slburris/Projects-FINTA/KiCAD/gps/errata.txt

Resolved in 1.1

Q2 is hidden on silkscreen after transistor is installed
Raspberry pi header is rotated 180 degrees

Unresolved

Display connector is wrong type, should be from the PH series
Adafruit GPS pinout silkscreen not visible after module is mounted, should also
J10 (USB A connector) should have plated through holes for the two mounting pins
0.22uf COG cap not available in 0603
