slburris/Projects-FINTA/KiCAD/disciplined-ocxo/disciplined-ocxo.pdf

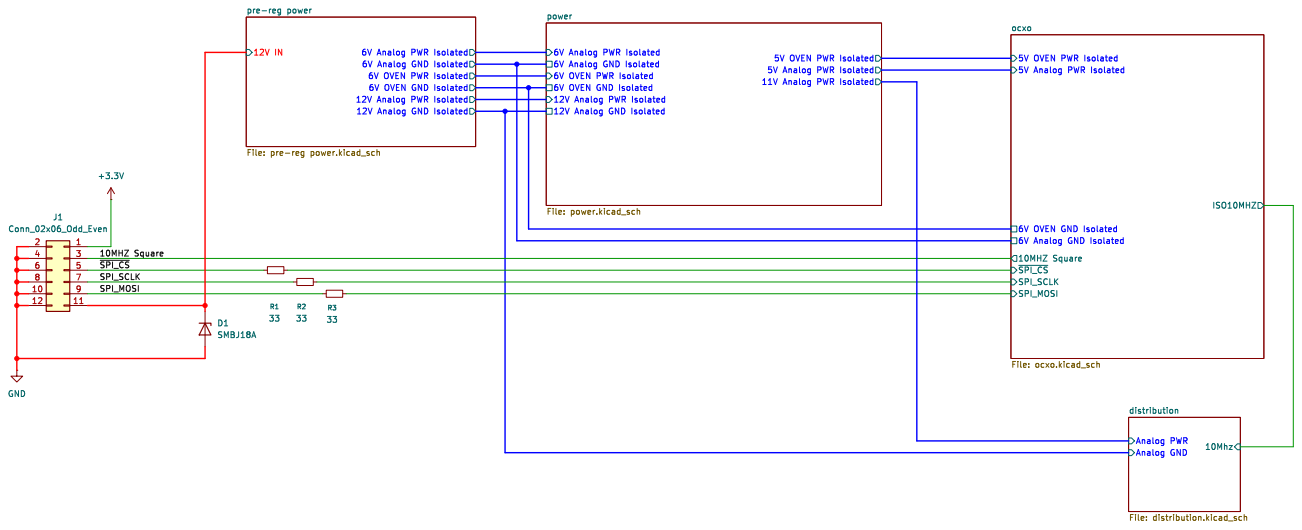
[picture p1: page 1]

6V Analog PWR Isolated
5V OVEN PWR Isolated 6V Analog GND Isolated
6V OVEN GND Isolated
12V Analog PWR Isolated
12V Analog GND Isolated

Id: 1/9 Title: File: disciplined-ocxo.kicad_sch Sheet: /

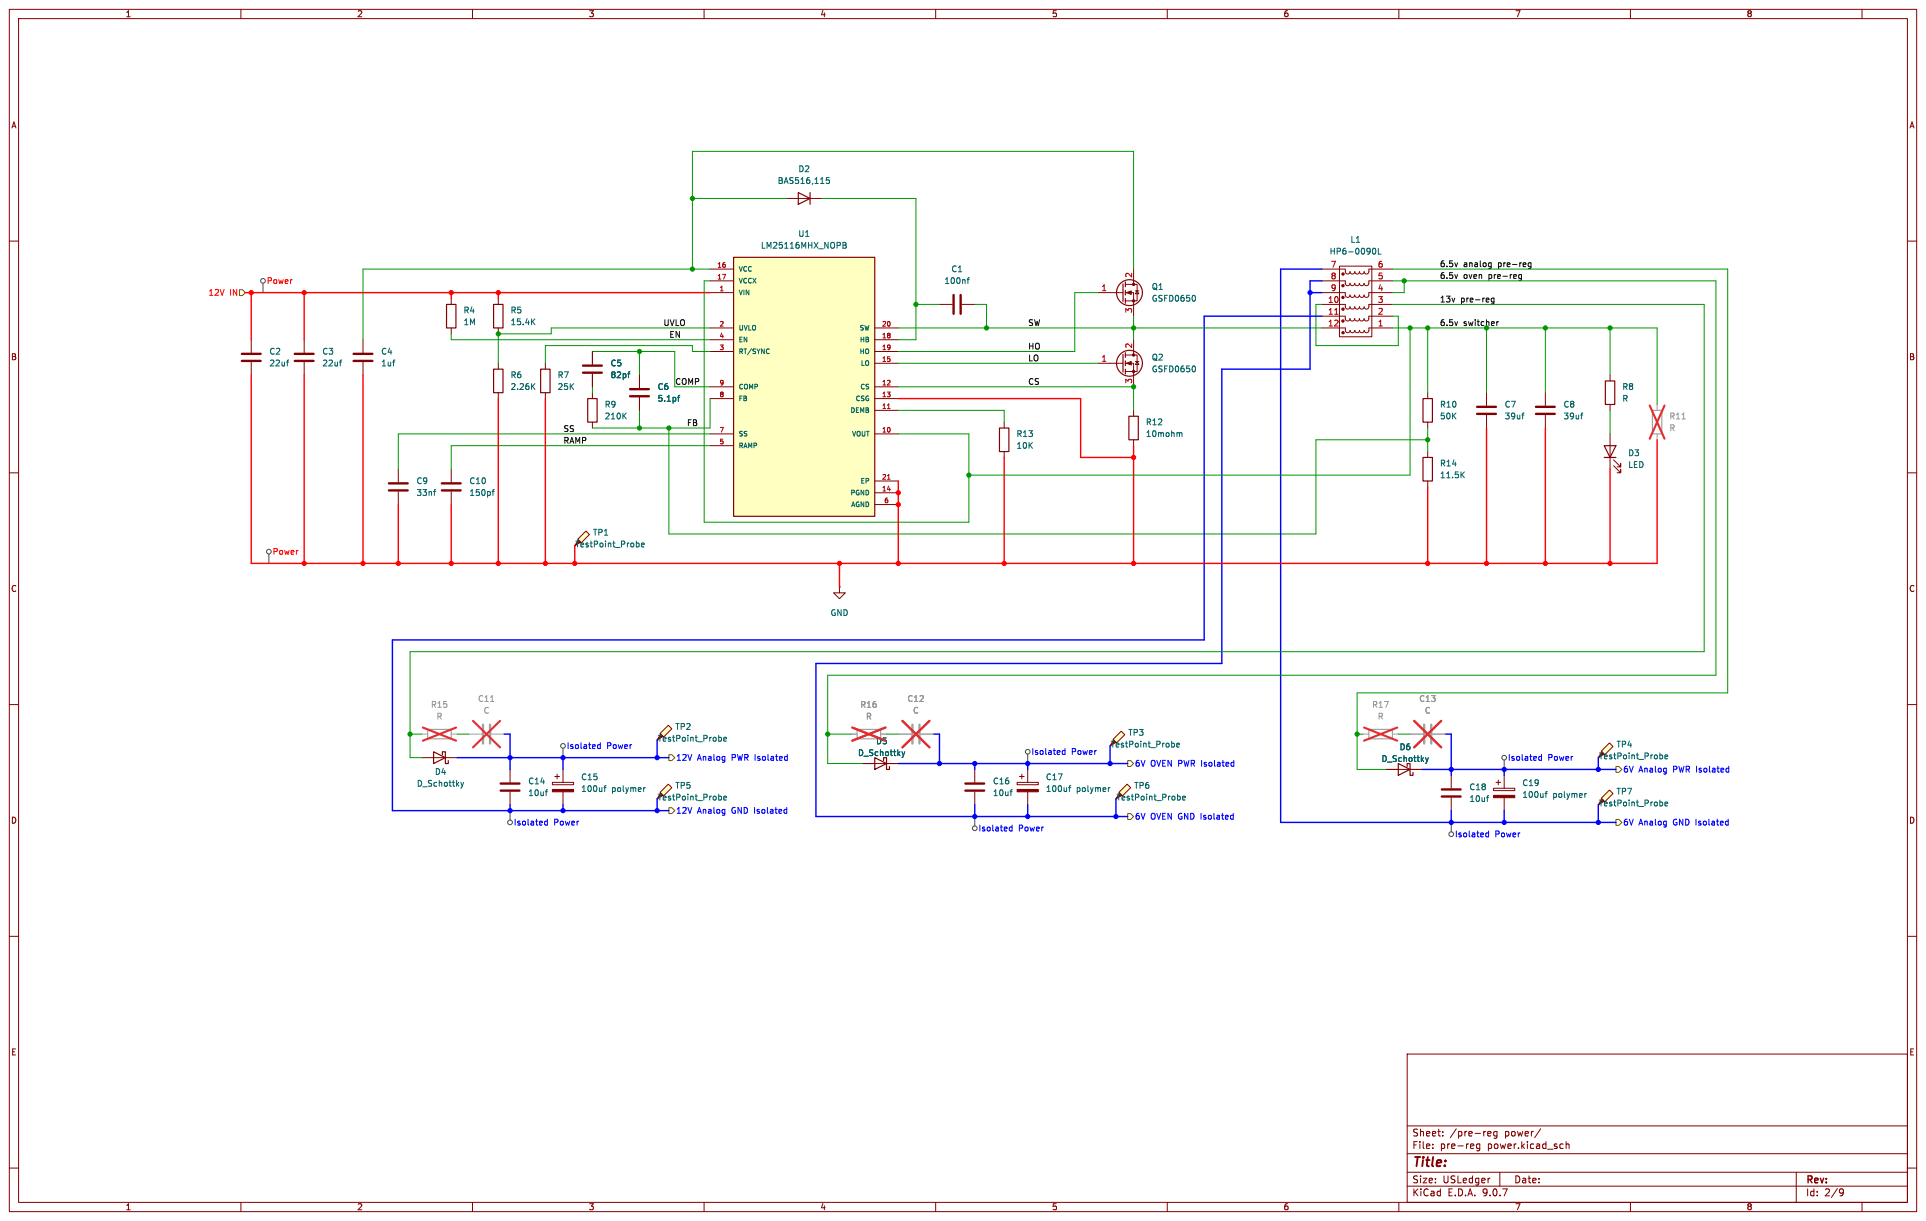
[picture p2: page 2]

6.5v analog pre-reg FB

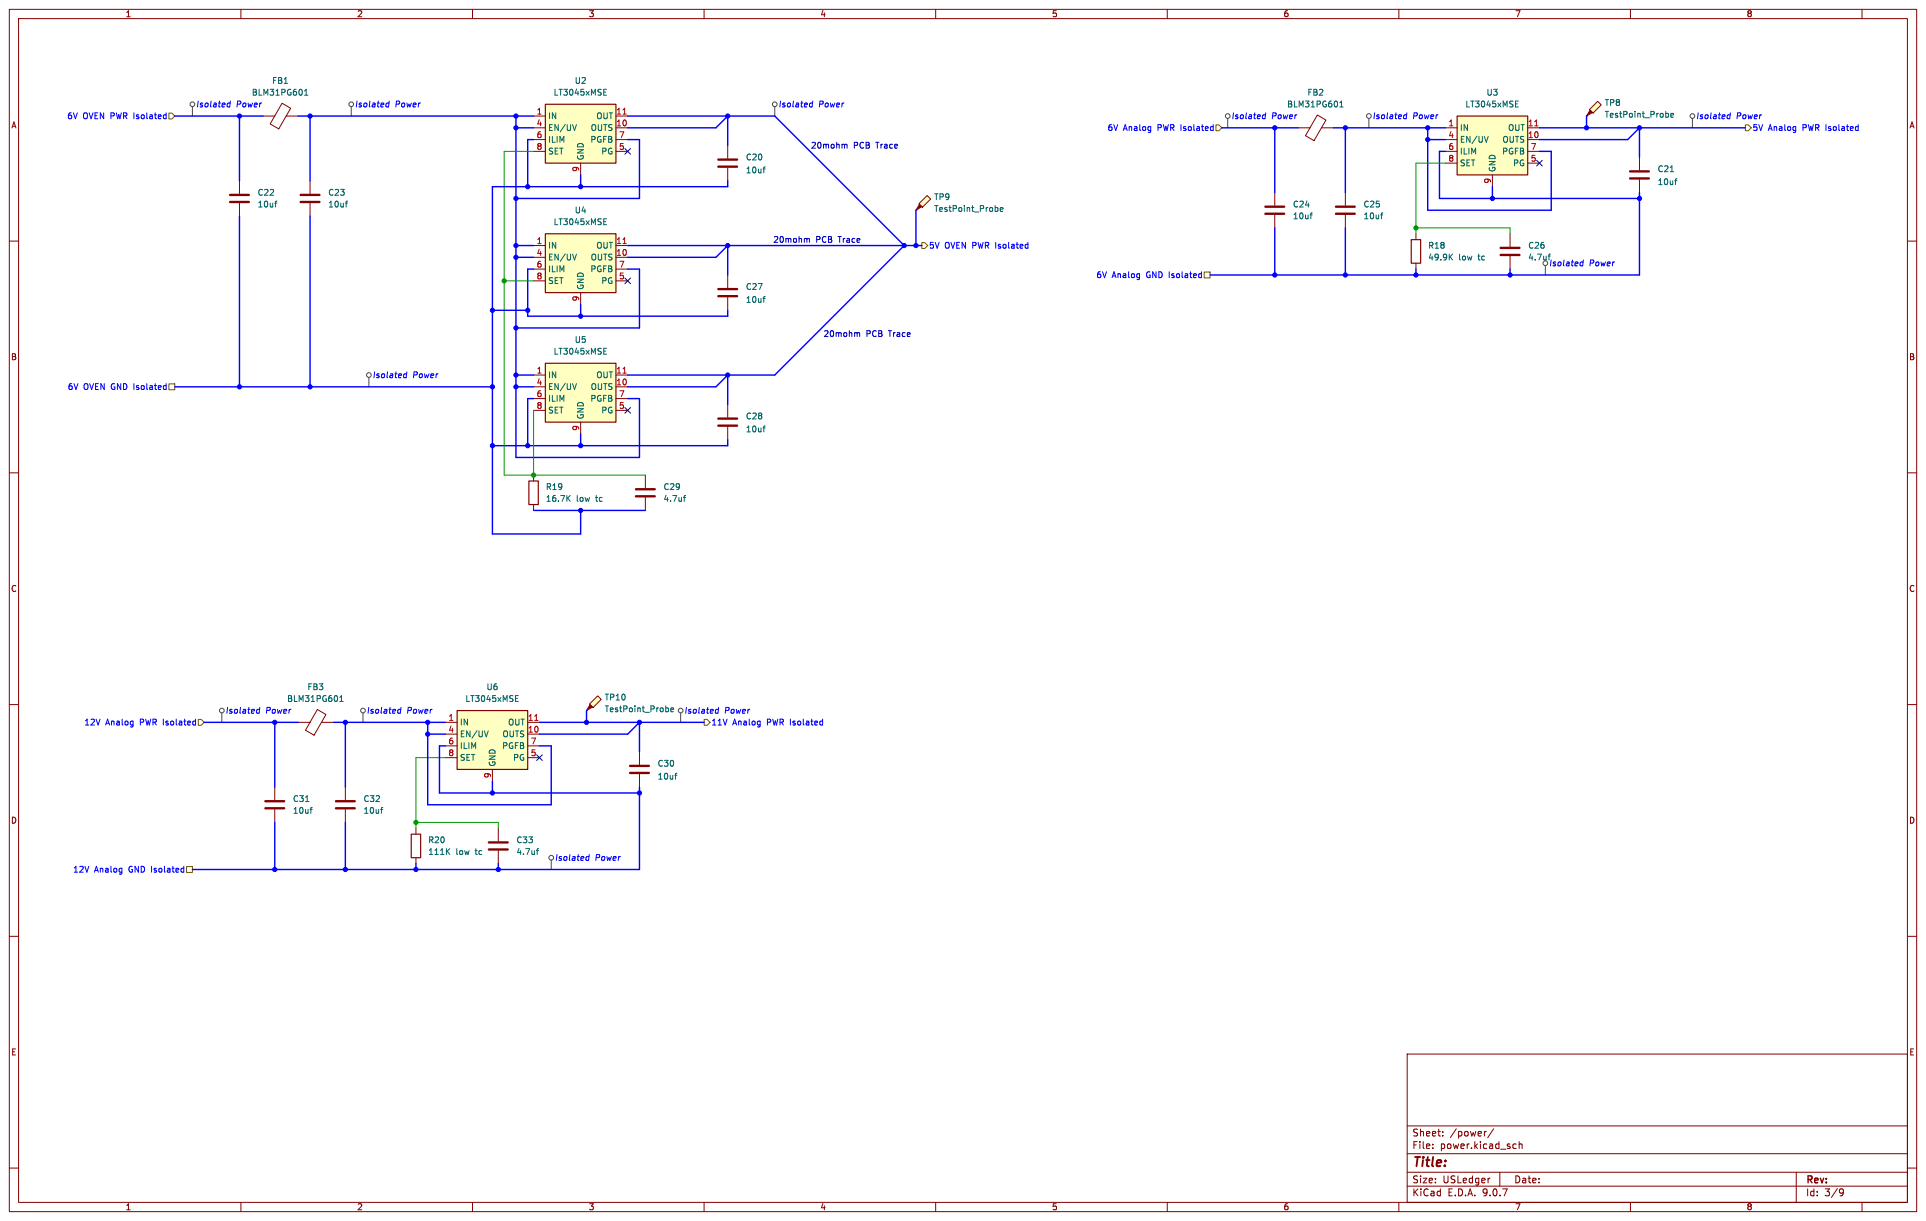
[picture p3: page 3]

9 OUT 11 OUTS 10 PGFB 7 PG 5 U2
LT3045xMSE

9 OUT 11 OUTS 10 PGFB 7 PG 5 U3

9 OUT 11 OUTS 10 PGFB 7 PG 5 U4

9 OUT 11 OUTS 10 PGFB 7 PG 5 U5

9 OUT 11 OUTS 10 PGFB 7 PG 5 U6

Id: 3/9 Title: File: power.kicad_sch Sheet: /power/

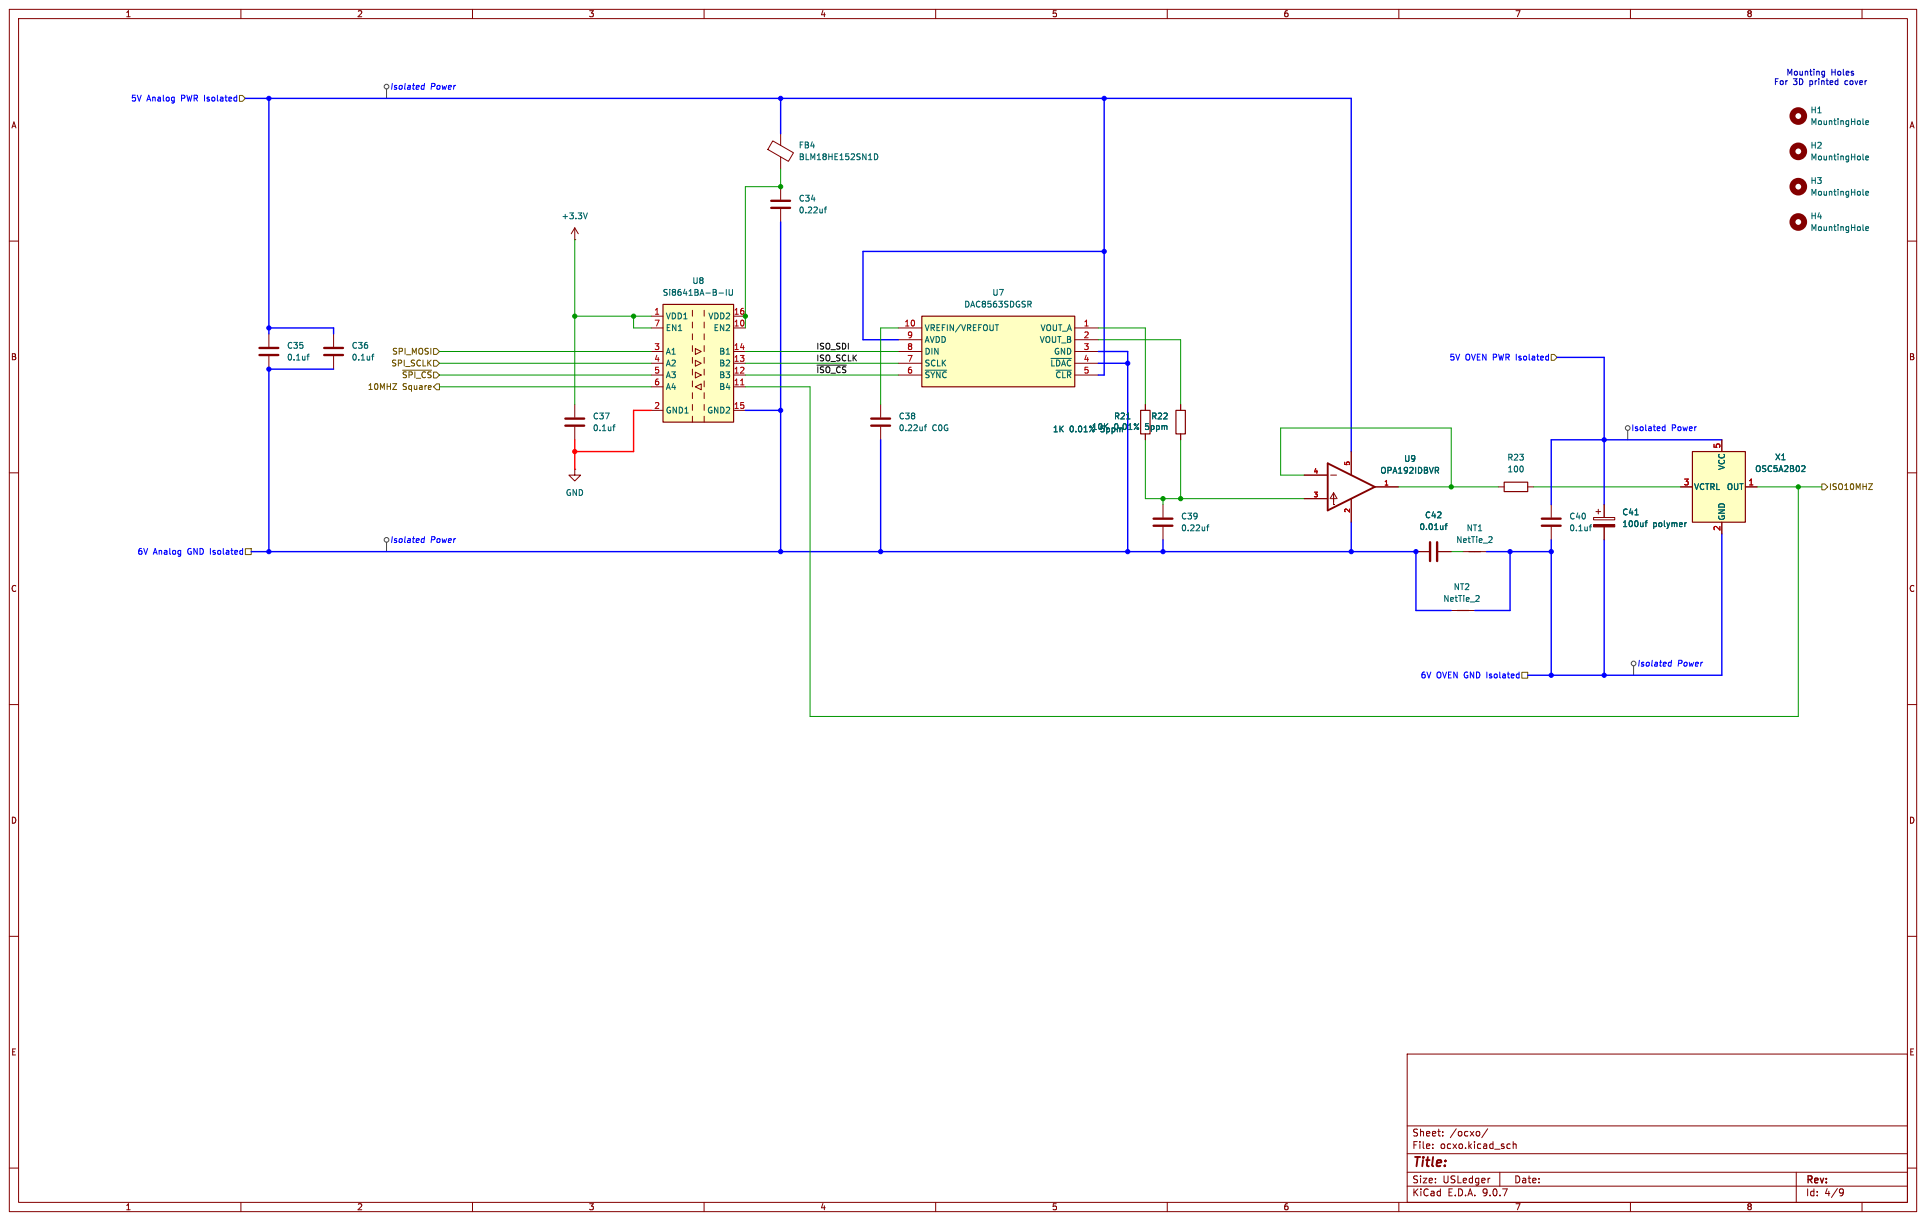
[picture p4: page 4]

Isolated Power 6V Analog GND Isolated

Id: 4/9 Title: File: ocxo.kicad_sch Sheet: /ocxo/

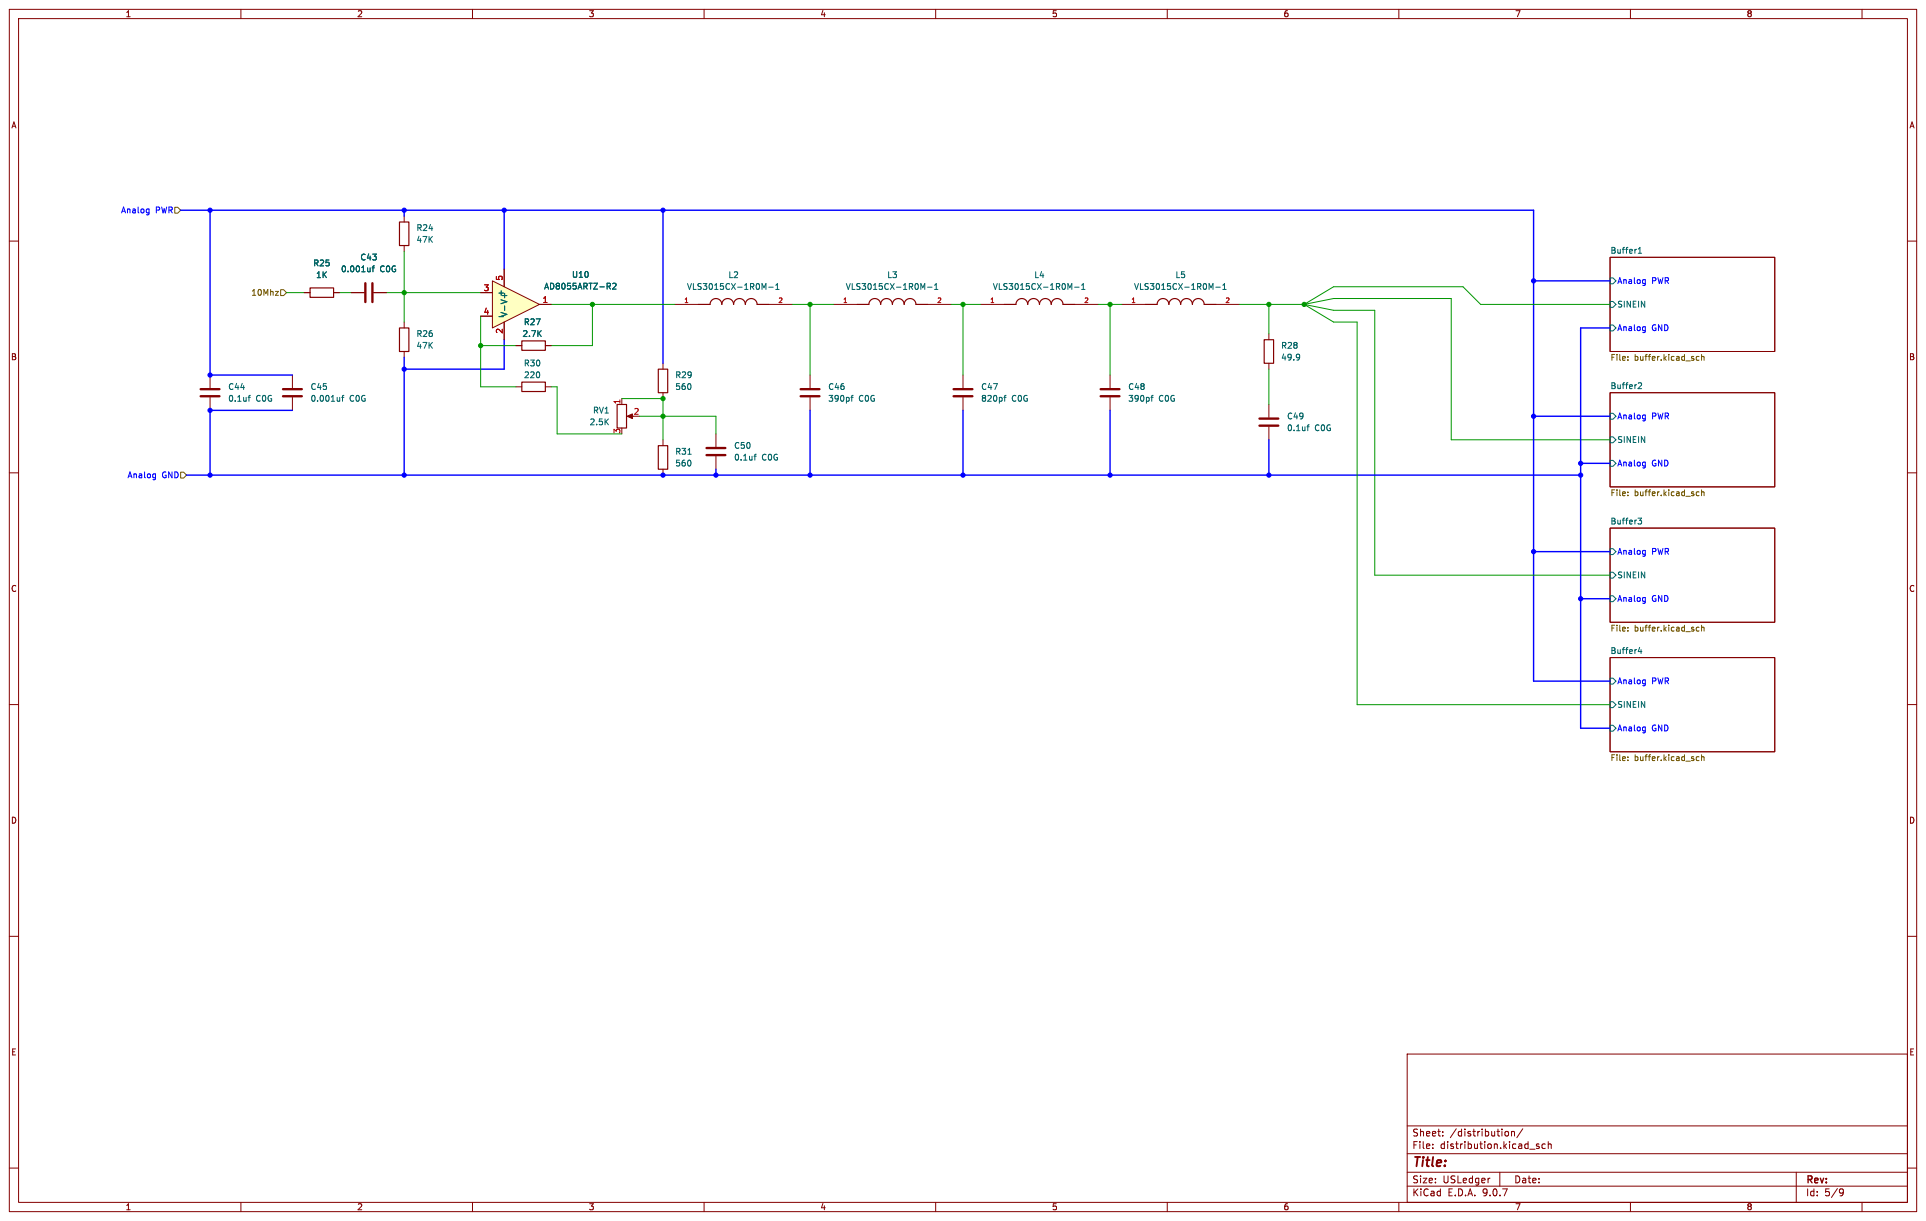
[picture p5: page 5]

Id: 5/9 Title: File: distribution.kicad_sch Sheet: /distribution/

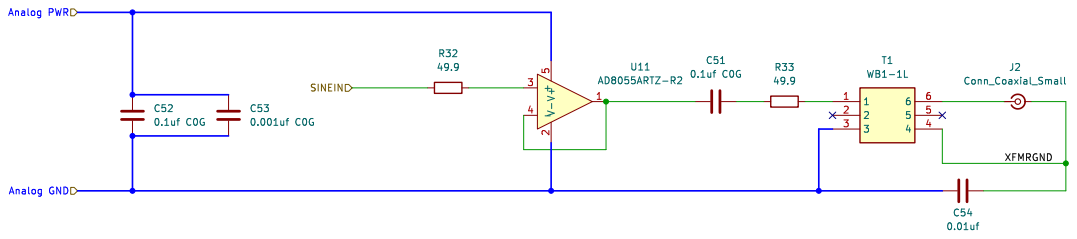
[picture p6: page 6]

Id: 6/9 Title: File: buffer.kicad_sch Sheet: /distribution/Buffer1/

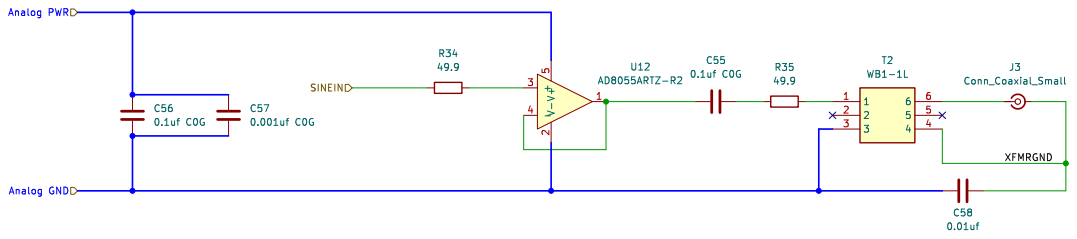
[picture p7: page 7]

Id: 7/9 Title: File: buffer.kicad_sch Sheet: /distribution/Buffer2/

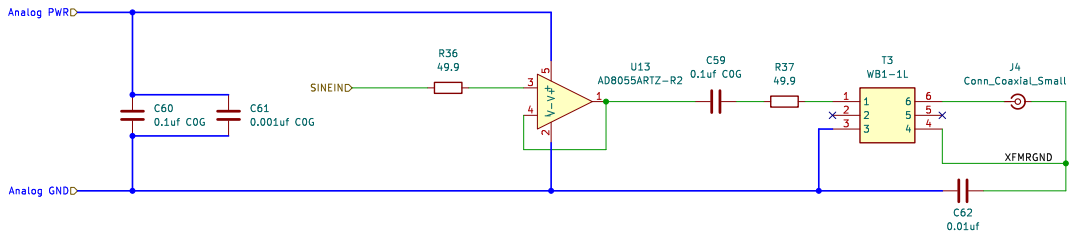
[picture p8: page 8]

Id: 8/9 Title: File: buffer.kicad_sch Sheet: /distribution/Buffer3/

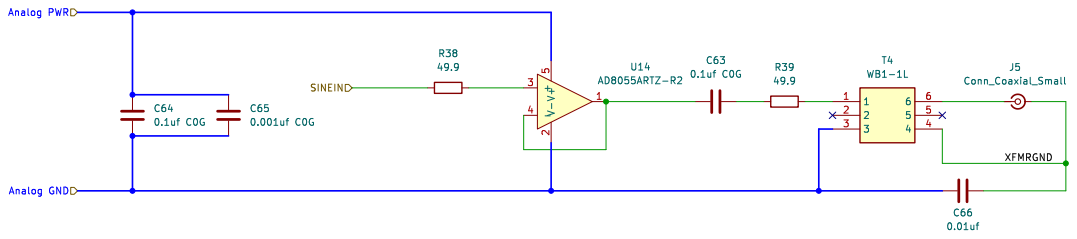
[picture p9: page 9]

Id: 9/9 Title: File: buffer.kicad_sch Sheet: /distribution/Buffer4/
