slburris/Projects-FINTA/KiCAD/IRIG/IRIG.pdf

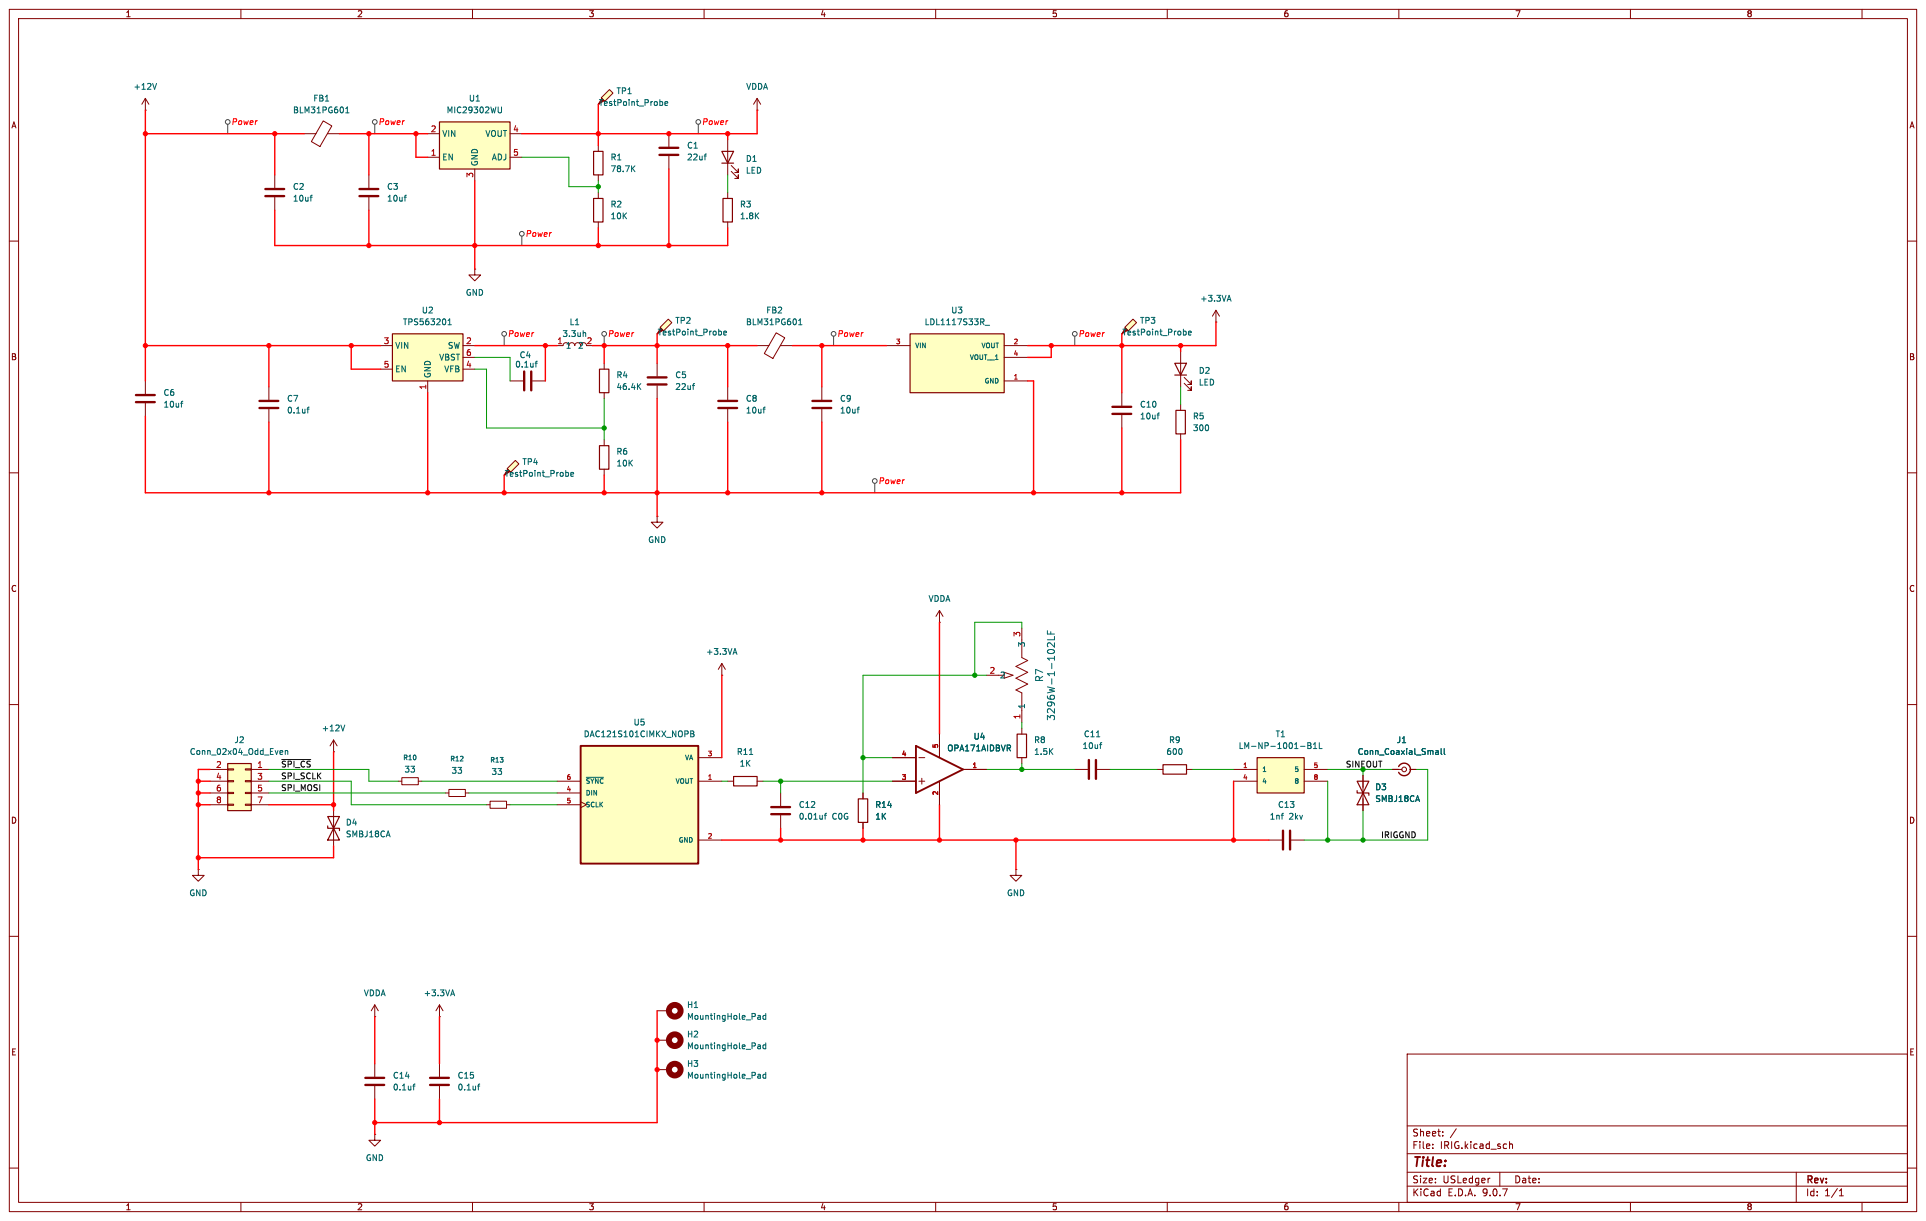
[picture p10: page 1]

Id: 1/1 Title: File: IRIG.kicad_sch Sheet: /
