slburris/Projects-FINTA/KiCAD/lownoise-LDO/lownoise-LDO.kicad_pcb

## KiCad design KiCAD/lownoise-LDO/lownoise-LDO.kicad_pcb (2026-05-15)

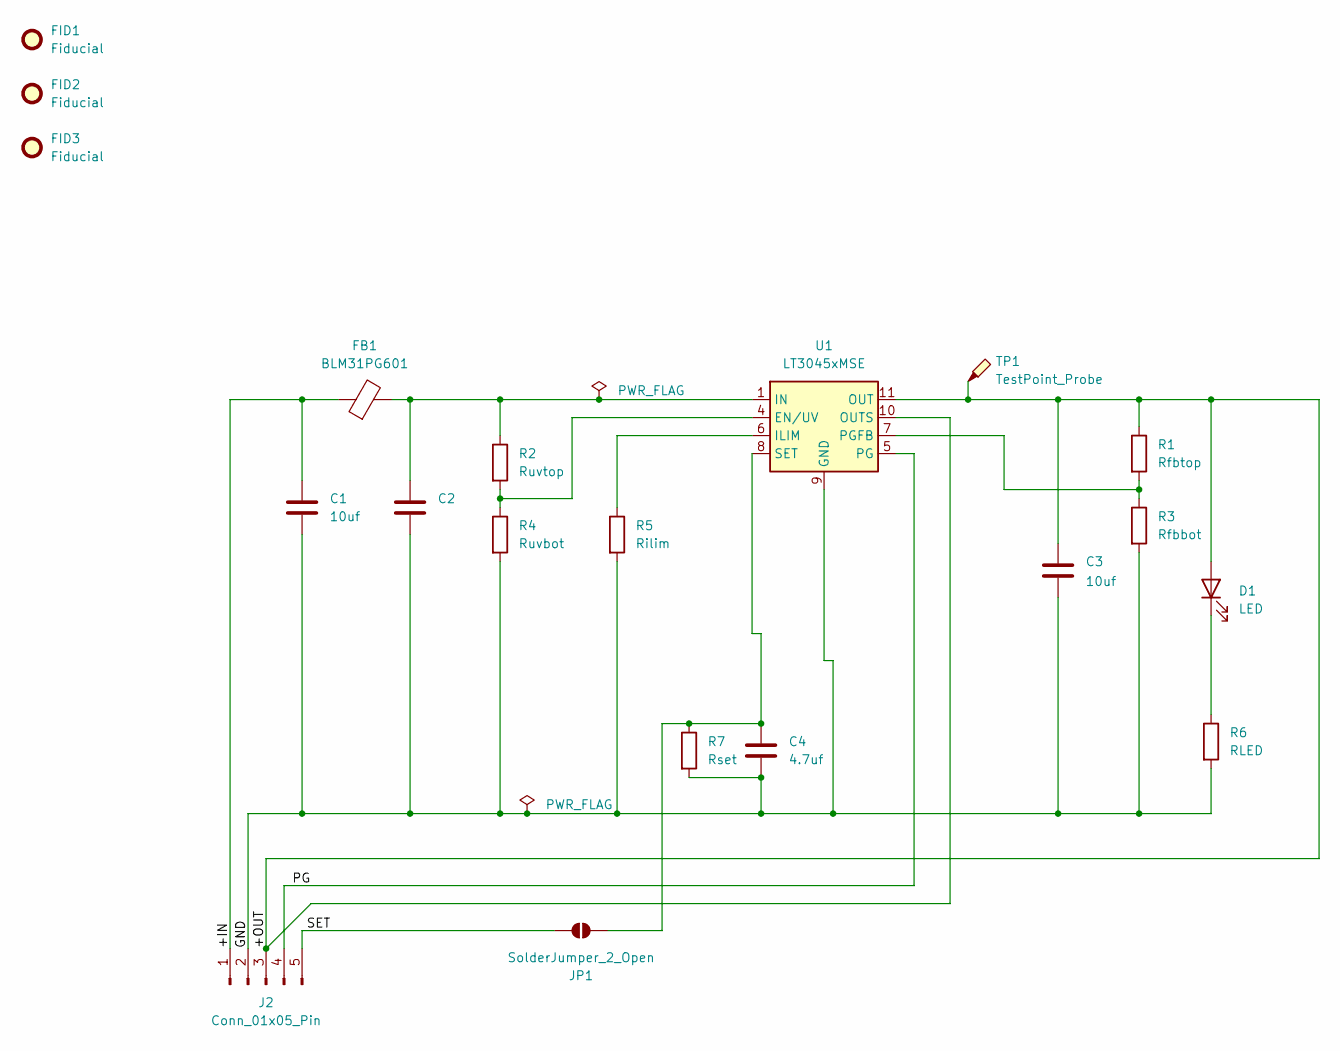
[picture p11: schematic lownoise-LDO.kicad_sch]

Parts:
C1, C2, C3: 10uf; C_0603_1608Metric_Pad1.08x0.95mm_HandSolder
C4: 4.7uf; C_0603_1608Metric_Pad1.08x0.95mm_HandSolder
D1: LED; LED_D3.0mm_Horizontal_O1.27mm_Z2.0mm
FB1: BLM31PG601; L_1206_3216Metric_Pad1.22x1.90mm_HandSolder
FID1, FID2, FID3: Fiducial; Fiducial_1mm_Mask2mm
J2: Conn_01x05_Pin; PinHeader_1x05_P2.00mm_Horizontal
JP1: SolderJumper_2_Open; SolderJumper-2_P1.3mm_Open_TrianglePad1.0x1.5mm
R1: Rfbtop; R_0603_1608Metric_Pad0.98x0.95mm_HandSolder
R2: Ruvtop; R_0603_1608Metric_Pad0.98x0.95mm_HandSolder
R3: Rfbbot; R_0603_1608Metric_Pad0.98x0.95mm_HandSolder
R4: Ruvbot; R_0603_1608Metric_Pad0.98x0.95mm_HandSolder
R5: Rilim; R_0603_1608Metric_Pad0.98x0.95mm_HandSolder
R6: RLED; R_0603_1608Metric_Pad0.98x0.95mm_HandSolder
R7: Rset; R_0603_1608Metric_Pad0.98x0.95mm_HandSolder
TP1: TestPoint_Probe; TestPoint_Pad_2.0x2.0mm
U1: LT3045xMSE; MSOP-12-1EP_3x4.039mm_P0.65mm_EP1.651x2.845mm

Connections:
/+IN: C1.1, FB1.1, J2.1
/+OUT: C3.1, D1.2 (A), J2.3, R1.1, TP1.1, U1.10 (OUTS), U1.11 (OUT), U1.12 (OUT)
/GND: C1.2, C2.2, C3.2, C4.2, J2.2, R3.2, R4.2, R5.2, R6.2, R7.2, U1.9 (GND), U1.13 (GND)
/PG: J2.4, U1.5 (PG)
/SET: J2.5, JP1.1 (A)
unnamed: C2.1, FB1.2, R2.1, U1.1 (IN), U1.2 (IN), U1.3 (IN)
unnamed: D1.1 (K), R6.1
unnamed: C4.1, JP1.2 (B), R7.1, U1.8 (SET)
unnamed: R2.2, R4.1, U1.4 (EN/UV)
unnamed: R5.1, U1.6 (ILIM)
unnamed: R1.2, R3.1, U1.7 (PGFB)

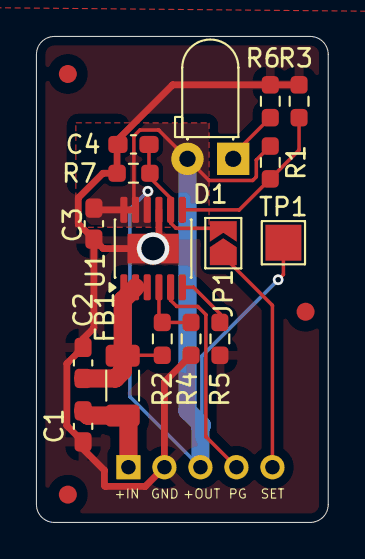
[picture p12: board lownoise-LDO.kicad_pcb from above]

Board: 2 copper layers, 16.2 x 27.0 mm, 20 parts (1 on the bottom side), 11 nets.
