slburris/Projects-FINTA/KiCAD/disciplined-ocxo/disciplined-ocxo.kicad_pcb

## KiCad design KiCAD/disciplined-ocxo/disciplined-ocxo.kicad_pcb (2026-05-14)

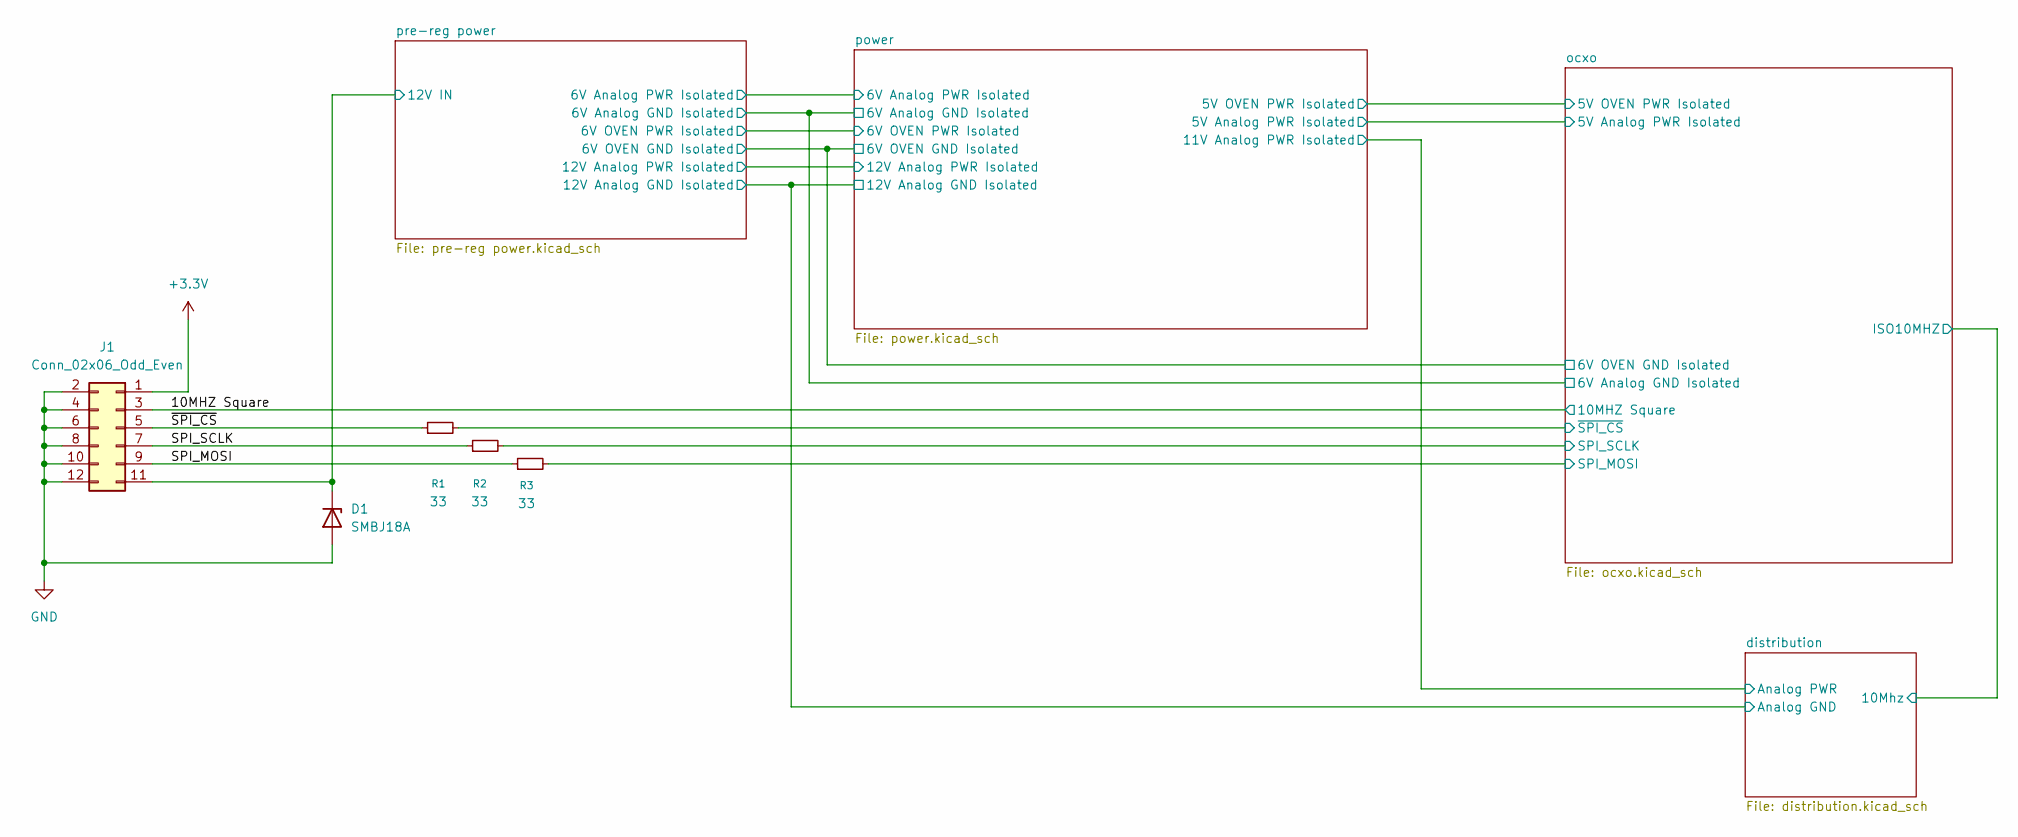
[picture p13: schematic disciplined-ocxo.kicad_sch]

Parts:
D1: SMBJ18A; D_SMB_Handsoldering
J1: Conn_02x06_Odd_Even; PinHeader_2x06_P2.54mm_Horizontal
R1, R2, R3: 33; R_1206_3216Metric_Pad1.30x1.75mm_HandSolder

Connections:
+3.3V: J1.1; also elsewhere on the board
/10MHZ Square: J1.3; also elsewhere on the board
/SPI_MOSI: J1.9, R3.1
/SPI_SCLK: J1.7, R2.1
/ocxo/SPI_MOSI: R3.2; also elsewhere on the board
/ocxo/SPI_SCLK: R2.2; also elsewhere on the board
/ocxo/~SPI_CS: R1.2; also elsewhere on the board
/pre-reg power/12V IN: D1.1 (K), J1.11; also elsewhere on the board
/~SPI_CS: J1.5, R1.1
GND: D1.2 (A), J1.2, J1.4, J1.6, J1.8, J1.10, J1.12; also elsewhere on the board

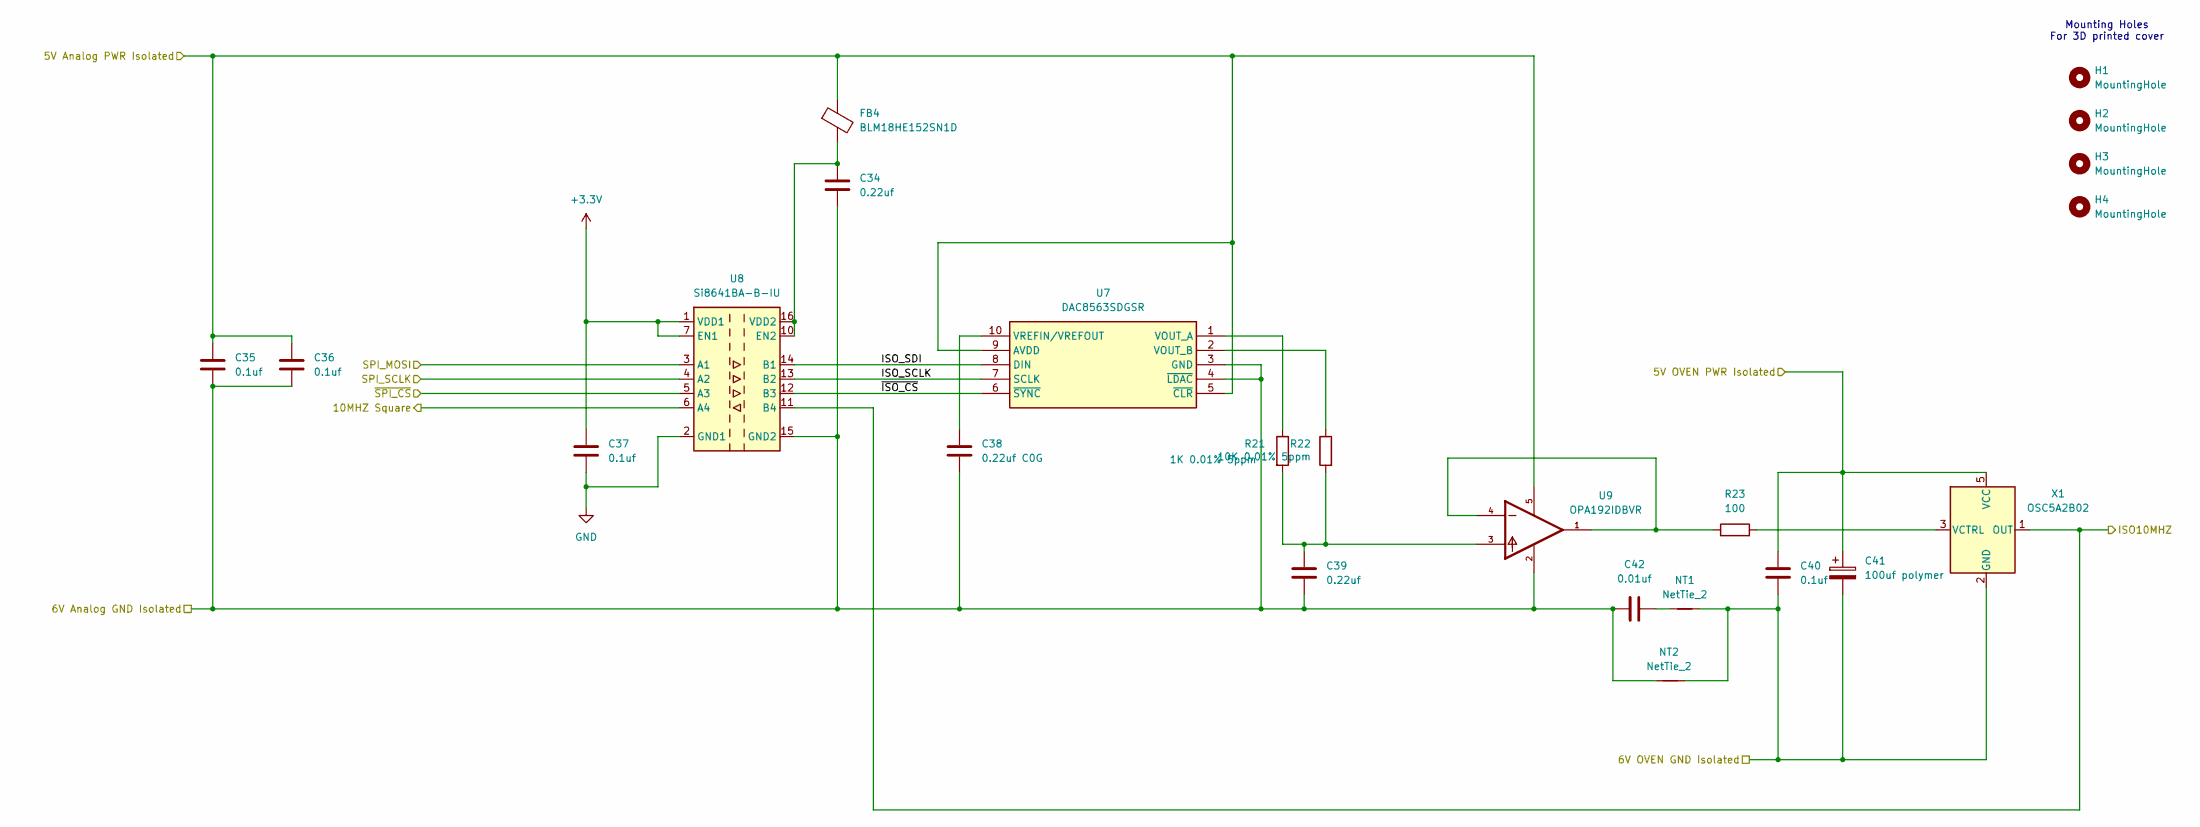
[picture p14: schematic ocxo.kicad_sch]

Parts:
C34, C39: 0.22uf; C_1206_3216Metric_Pad1.33x1.80mm_HandSolder
C35, C36, C37, C40: 0.1uf; C_0603_1608Metric_Pad1.08x0.95mm_HandSolder
C38: 0.22uf C0G; C_0603_1608Metric_Pad1.08x0.95mm_HandSolder
C41: 100uf polymer; CP_Radial_D5.0mm_P2.00mm
C42: 0.01uf; C_0603_1608Metric_Pad1.08x0.95mm_HandSolder
FB4: BLM18HE152SN1D; L_0603_1608Metric_Pad1.05x0.95mm_HandSolder
H1, H2, H3, H4: MountingHole; MountingHole_3.2mm_M3
NT1, NT2: NetTie_2; NetTie-2_SMD_Pad0.5mm
R21: 1K 0.01% 5ppm; R_0805_2012Metric_Pad1.20x1.40mm_HandSolder
R22: 10K 0.01% 5ppm; R_0805_2012Metric_Pad1.20x1.40mm_HandSolder
R23: 100; R_1206_3216Metric_Pad1.30x1.75mm_HandSolder
U7: DAC8563SDGSR; SOP50P490X110-10N; Manufacturer_Part_Number DAC8563SDGSR; Mouser Part Number 595-DAC8563SDGSR
U8: Si8641BA-B-IU; QSOP-16_3.9x4.9mm_P0.635mm
U9: OPA192IDBVR; SOT95P280X145-5N; PARTREV F
X1: OSC5A2B02; CTI-OSC-25x25

Connections:
+3.3V: C37.2, U8.1 (VDD1), U8.7 (EN1); also elsewhere on the board
/10MHZ Square: U8.6 (A4); also elsewhere on the board
/distribution/10Mhz: U8.11 (B4), X1.1 (OUT); also elsewhere on the board
/ocxo/5V Analog PWR Isolated: C35.1, C36.1, FB4.1, U7.5 (~CLR), U7.9 (AVDD), U9.5; also elsewhere on the board
/ocxo/5V OVEN PWR Isolated: C40.1, C41.1, X1.5 (VCC); also elsewhere on the board
/ocxo/6V Analog GND Isolated: C34.2, C35.2, C36.2, C38.2, C39.2, C42.1, NT2.1, U7.3 (GND), U7.4 (~LDAC), U8.9 (GND2), U8.15 (GND2), U9.2; also elsewhere on the board
/ocxo/6V OVEN GND Isolated: C40.2, C41.2, NT1.2, NT2.2, X1.2 (GND); also elsewhere on the board
/ocxo/ISO_SCLK: U7.7 (SCLK), U8.13 (B2)
/ocxo/ISO_SDI: U7.8 (DIN), U8.14 (B1)
/ocxo/SPI_MOSI: U8.3 (A1); also elsewhere on the board
/ocxo/SPI_SCLK: U8.4 (A2); also elsewhere on the board
/ocxo/~ISO_CS: U7.6 (~SYNC), U8.12 (B3)
/ocxo/~SPI_CS: U8.5 (A3); also elsewhere on the board
GND: C37.1, U8.2 (GND1), U8.8 (GND1); also elsewhere on the board
unnamed: C39.1, R21.2, R22.2, U9.3
unnamed: C42.2, NT1.1
unnamed: R23.1, U9.1, U9.4
unnamed: R21.1, U7.1 (VOUT_A)
unnamed: R22.1, U7.2 (VOUT_B)
unnamed: C38.1, U7.10 (VREFIN/VREFOUT)
unnamed: C34.1, FB4.2, U8.10 (EN2), U8.16 (VDD2)
unnamed: R23.2, X1.3 (VCTRL)

Notes on the sheet:
Mounting Holes For 3D printed cover

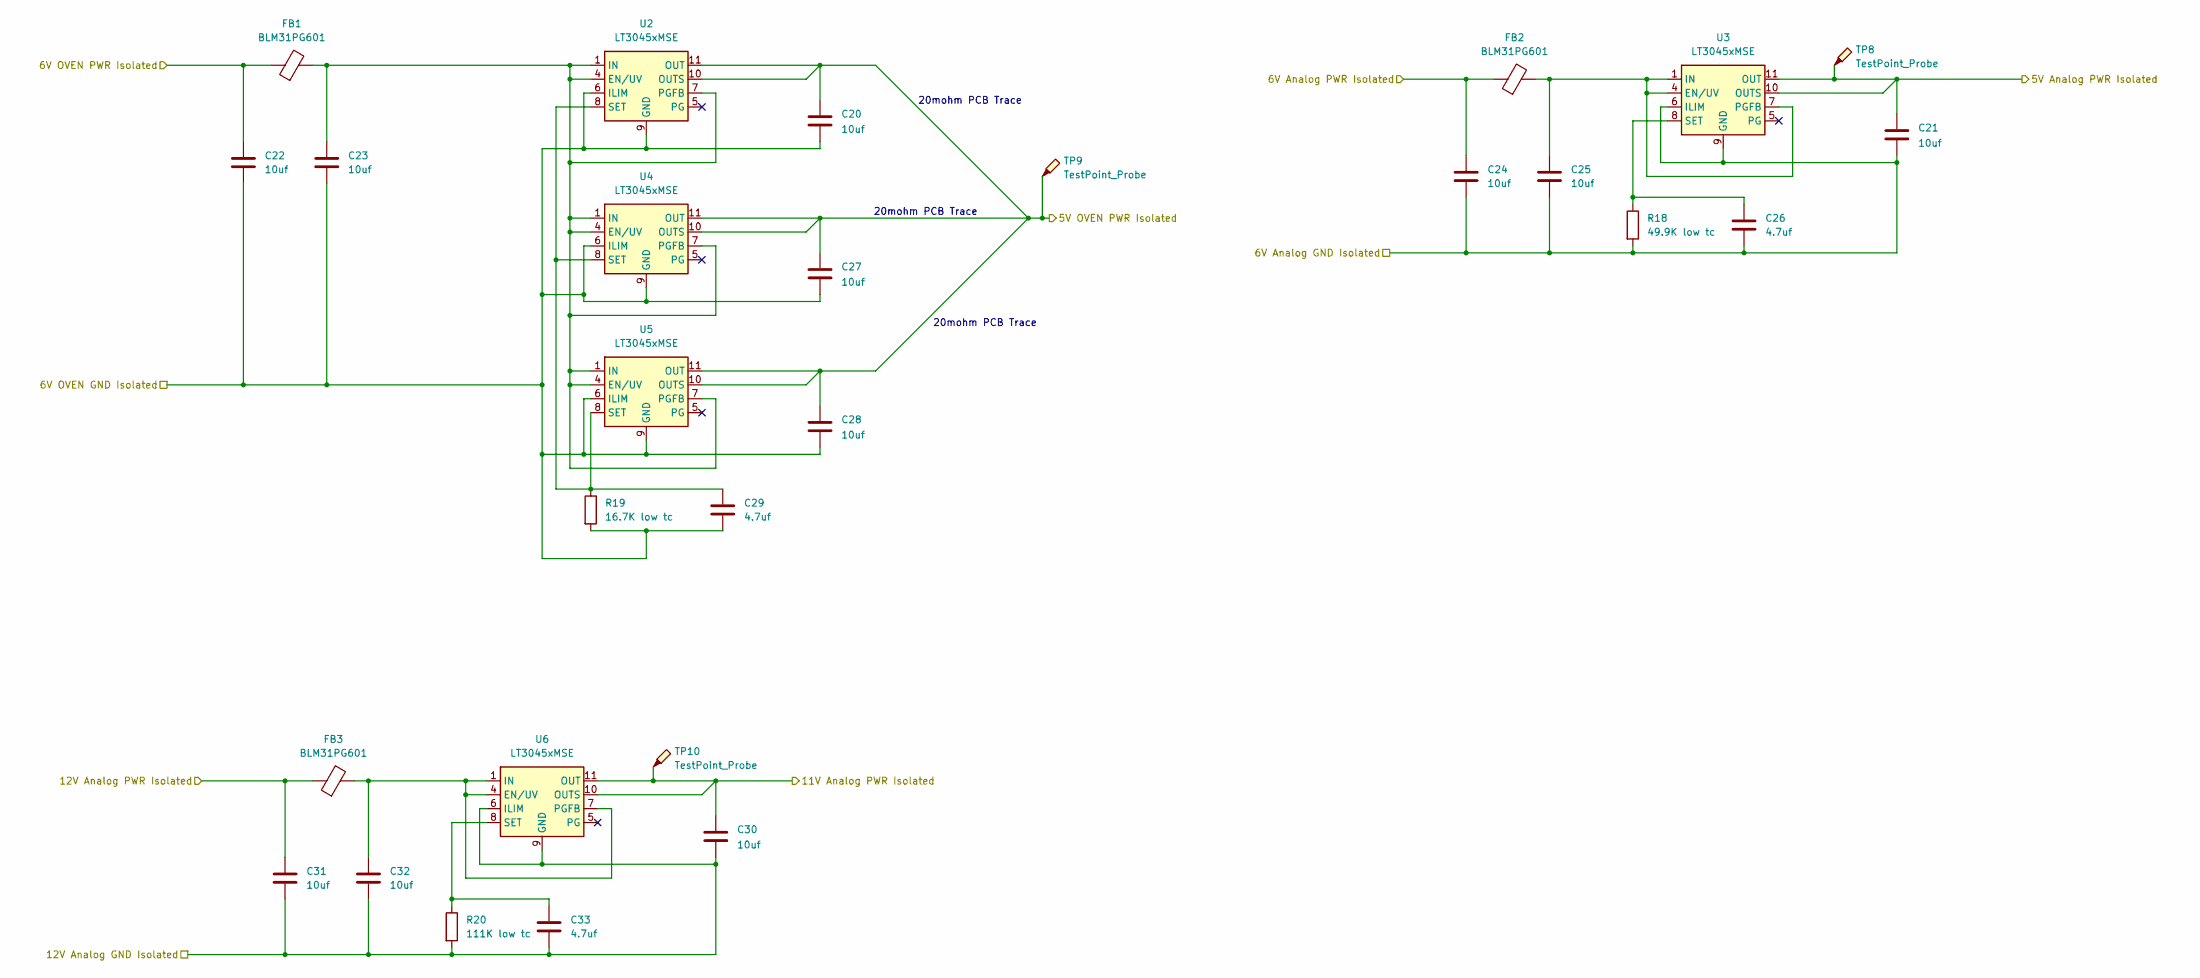
[picture p15: schematic power.kicad_sch]

Parts:
C20, C21, C22, C23, C24, C25, C27, C28, C30, C31, C32: 10uf; C_0603_1608Metric_Pad1.08x0.95mm_HandSolder
C26, C29, C33: 4.7uf; C_0603_1608Metric_Pad1.08x0.95mm_HandSolder
FB1, FB2, FB3: BLM31PG601; L_1206_3216Metric_Pad1.22x1.90mm_HandSolder
R18: 49.9K low tc; R_0603_1608Metric_Pad0.98x0.95mm_HandSolder
R19: 16.7K low tc; R_0603_1608Metric_Pad0.98x0.95mm_HandSolder
R20: 111K low tc; R_0603_1608Metric_Pad0.98x0.95mm_HandSolder
TP8, TP9, TP10: TestPoint_Probe; TestPoint_Pad_2.0x2.0mm
U2, U3, U4, U5, U6: LT3045xMSE; MSOP-12-1EP_3x4.039mm_P0.65mm_EP1.651x2.845mm

Connections:
/distribution/Analog GND: C30.2, C31.2, C32.2, C33.2, R20.2, U6.6 (ILIM), U6.9 (GND), U6.13 (GND); also elsewhere on the board
/distribution/Analog PWR: C30.1, TP10.1, U6.10 (OUTS), U6.11 (OUT), U6.12 (OUT); also elsewhere on the board
/ocxo/5V Analog PWR Isolated: C21.1, TP8.1, U3.10 (OUTS), U3.11 (OUT), U3.12 (OUT); also elsewhere on the board
/ocxo/5V OVEN PWR Isolated: C20.1, C27.1, C28.1, TP9.1, U2.10 (OUTS), U2.11 (OUT), U2.12 (OUT), U4.10 (OUTS), U4.11 (OUT), U4.12 (OUT), U5.10 (OUTS), U5.11 (OUT), U5.12 (OUT); also elsewhere on the board
/ocxo/6V Analog GND Isolated: C21.2, C24.2, C25.2, C26.2, R18.2, U3.6 (ILIM), U3.9 (GND), U3.13 (GND); also elsewhere on the board
/ocxo/6V OVEN GND Isolated: C20.2, C22.2, C23.2, C27.2, C28.2, C29.2, R19.2, U2.6 (ILIM), U2.9 (GND), U2.13 (GND), U4.6 (ILIM), U4.9 (GND), U4.13 (GND), U5.6 (ILIM), U5.9 (GND), U5.13 (GND); also elsewhere on the board
/power/6V Analog PWR Isolated: C24.1, FB2.1; also elsewhere on the board
/power/6V OVEN PWR Isolated: C22.1, FB1.1; also elsewhere on the board
/power/12V Analog PWR Isolated: C31.1, FB3.1; also elsewhere on the board
unnamed: C23.1, FB1.2, U2.1 (IN), U2.2 (IN), U2.3 (IN), U2.4 (EN/UV), U2.7 (PGFB), U4.1 (IN), U4.2 (IN), U4.3 (IN), U4.4 (EN/UV), U4.7 (PGFB), U5.1 (IN), U5.2 (IN), U5.3 (IN), U5.4 (EN/UV), U5.7 (PGFB)
unnamed: C29.1, R19.1, U2.8 (SET), U4.8 (SET), U5.8 (SET)
unnamed: C25.1, FB2.2, U3.1 (IN), U3.2 (IN), U3.3 (IN), U3.4 (EN/UV), U3.7 (PGFB)
unnamed: C26.1, R18.1, U3.8 (SET)
unnamed: C32.1, FB3.2, U6.1 (IN), U6.2 (IN), U6.3 (IN), U6.4 (EN/UV), U6.7 (PGFB)
unnamed: C33.1, R20.1, U6.8 (SET)

Notes on the sheet:
20mohm PCB Trace

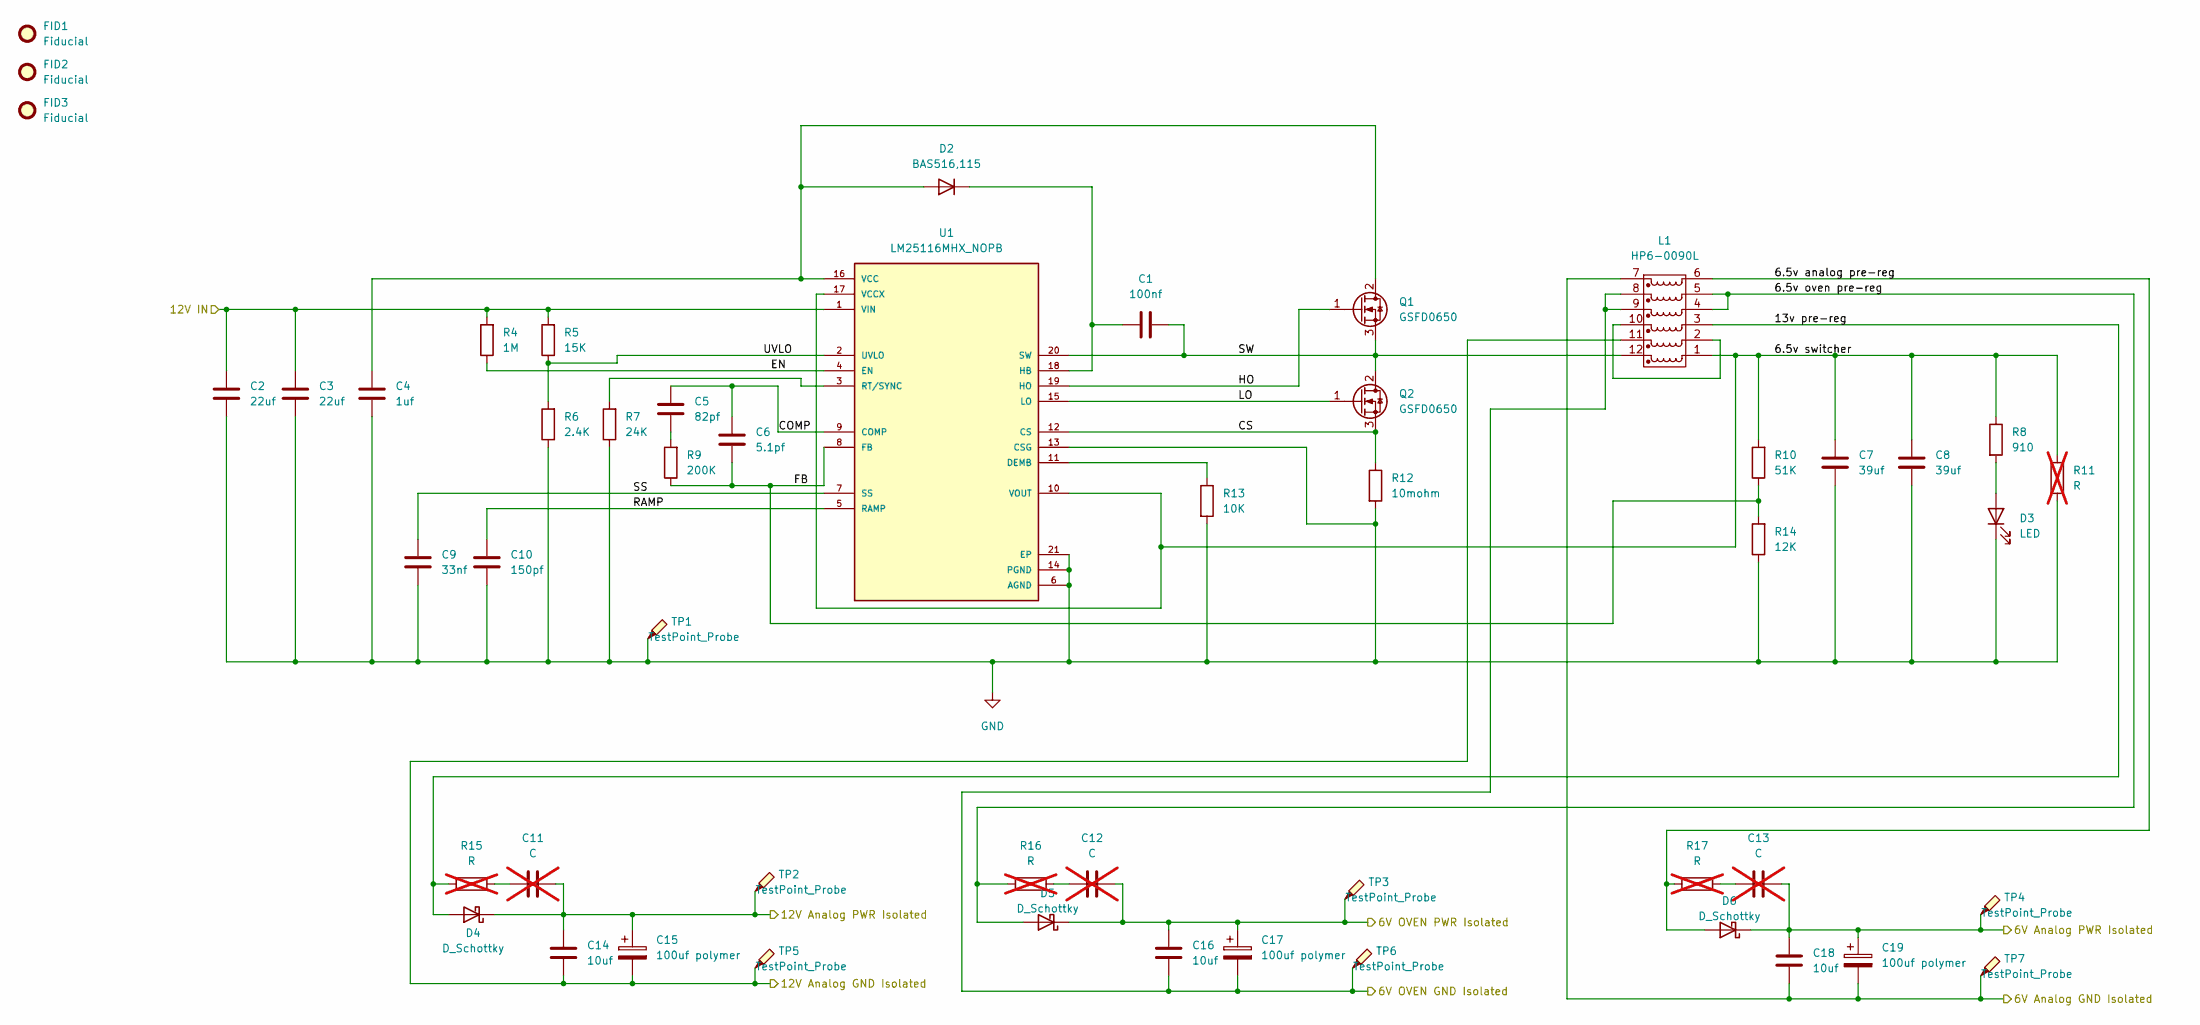
[picture p16: schematic pre-reg power.kicad_sch]

Parts:
C1: 100nf; C_0603_1608Metric_Pad1.08x0.95mm_HandSolder
C2, C3: 22uf; C_1206_3216Metric_Pad1.33x1.80mm_HandSolder
C4: 1uf; C_0603_1608Metric_Pad1.08x0.95mm_HandSolder
C5: 82pf; C_0603_1608Metric_Pad1.08x0.95mm_HandSolder
C6: 5.1pf; C_0603_1608Metric_Pad1.08x0.95mm_HandSolder
C7, C8: 39uf; C_1206_3216Metric_Pad1.33x1.80mm_HandSolder
C9: 33nf; C_0603_1608Metric_Pad1.08x0.95mm_HandSolder
C10: 150pf; C_0603_1608Metric_Pad1.08x0.95mm_HandSolder
C11, C12, C13: C; C_1206_3216Metric_Pad1.33x1.80mm_HandSolder; not fitted
C14, C16, C18: 10uf; C_1206_3216Metric_Pad1.33x1.80mm_HandSolder
C15, C17, C19: 100uf polymer; CP_Radial_D5.0mm_P2.00mm
D2: BAS516,115; D_SOD-523
D3: LED; LED_0805_2012Metric_Pad1.15x1.40mm_HandSolder
D4, D5, D6: D_Schottky; D_SMB_Handsoldering
FID1, FID2, FID3: Fiducial; Fiducial_1mm_Mask3mm
L1: HP6-0090L
Q1, Q2: GSFD0650; TO-252-2
R4: 1M; R_0603_1608Metric_Pad0.98x0.95mm_HandSolder
R5: 15K; R_0603_1608Metric_Pad0.98x0.95mm_HandSolder
R6: 2.4K; R_0603_1608Metric_Pad0.98x0.95mm_HandSolder
R7: 24K; R_0603_1608Metric_Pad0.98x0.95mm_HandSolder
R8: 910; R_1206_3216Metric_Pad1.30x1.75mm_HandSolder
R9: 200K; R_0603_1608Metric_Pad0.98x0.95mm_HandSolder
R10: 51K; R_0603_1608Metric_Pad0.98x0.95mm_HandSolder
R11, R15, R16, R17: R; R_1206_3216Metric_Pad1.30x1.75mm_HandSolder; not fitted
R12: 10mohm; R_1206_3216Metric_Pad1.30x1.75mm_HandSolder
R13: 10K; R_1206_3216Metric_Pad1.30x1.75mm_HandSolder
R14: 12K; R_0603_1608Metric_Pad0.98x0.95mm_HandSolder
TP1, TP2, TP3, TP4, TP5, TP6, TP7: TestPoint_Probe; TestPoint_Pad_2.0x2.0mm
U1: LM25116MHX_NOPB; SOP65P640X110-21N; PARTREV E

Connections:
/distribution/Analog GND: C14.2, C15.2, L1.11, TP5.1; also elsewhere on the board
/ocxo/6V Analog GND Isolated: C18.2, C19.2, L1.7, TP7.1; also elsewhere on the board
/ocxo/6V OVEN GND Isolated: C16.2, C17.2, L1.8, L1.9, TP6.1; also elsewhere on the board
/power/6V Analog PWR Isolated: C13.2, C18.1, C19.1, D6.1 (K), TP4.1; also elsewhere on the board
/power/6V OVEN PWR Isolated: C12.2, C16.1, C17.1, D5.1 (K), TP3.1; also elsewhere on the board
/power/12V Analog PWR Isolated: C11.2, C14.1, C15.1, D4.1 (K), TP2.1; also elsewhere on the board
/pre-reg power/6.5v analog pre-reg: D6.2 (A), L1.6, R17.1
/pre-reg power/6.5v oven pre-reg: D5.2 (A), L1.4, L1.5, R16.1
/pre-reg power/6.5v switcher: C7.1, C8.1, L1.1, R8.1, R10.2, R11.1, U1.10 (VOUT), U1.17 (VCCX)
/pre-reg power/12V IN: C2.1, C3.1, R4.2, R5.2, U1.1 (VIN); also elsewhere on the board
/pre-reg power/13v pre-reg: D4.2 (A), L1.3, R15.1
/pre-reg power/COMP: C5.1, C6.1, U1.9 (COMP)
/pre-reg power/CS: Q2.3 (S), R12.1, U1.12 (CS)
/pre-reg power/EN: R4.1, U1.4 (EN)
/pre-reg power/FB: C6.2, R9.1, R10.1, R14.2, U1.8 (FB)
/pre-reg power/HO: Q1.1 (G), U1.19 (HO)
/pre-reg power/LO: Q2.1 (G), U1.15 (LO)
/pre-reg power/RAMP: C10.1, U1.5 (RAMP)
/pre-reg power/SS: C9.1, U1.7 (SS)
/pre-reg power/SW: C1.2, L1.12, Q1.3 (S), Q2.2 (D), U1.20 (SW)
/pre-reg power/UVLO: R5.1, R6.2, U1.2 (UVLO)
GND: C2.2, C3.2, C4.2, C7.2, C8.2, C9.2, C10.2, D3.1 (K), R6.1, R7.1, R11.2, R12.2, R13.2, R14.1, TP1.1, U1.6 (AGND), U1.13 (CSG), U1.14 (PGND), U1.21 (EP); also elsewhere on the board
unnamed: C5.2, R9.2
unnamed: C11.1, R15.2
unnamed: C12.1, R16.2
unnamed: C13.1, R17.2
unnamed: C4.1, D2.2 (A), Q1.2 (D), U1.16 (VCC)
unnamed: C1.1, D2.1 (K), U1.18 (HB)
unnamed: D3.2 (A), R8.2
unnamed: L1.2, L1.10
unnamed: R13.1, U1.11 (DEMB)
unnamed: R7.2, U1.3 (RT/SYNC)

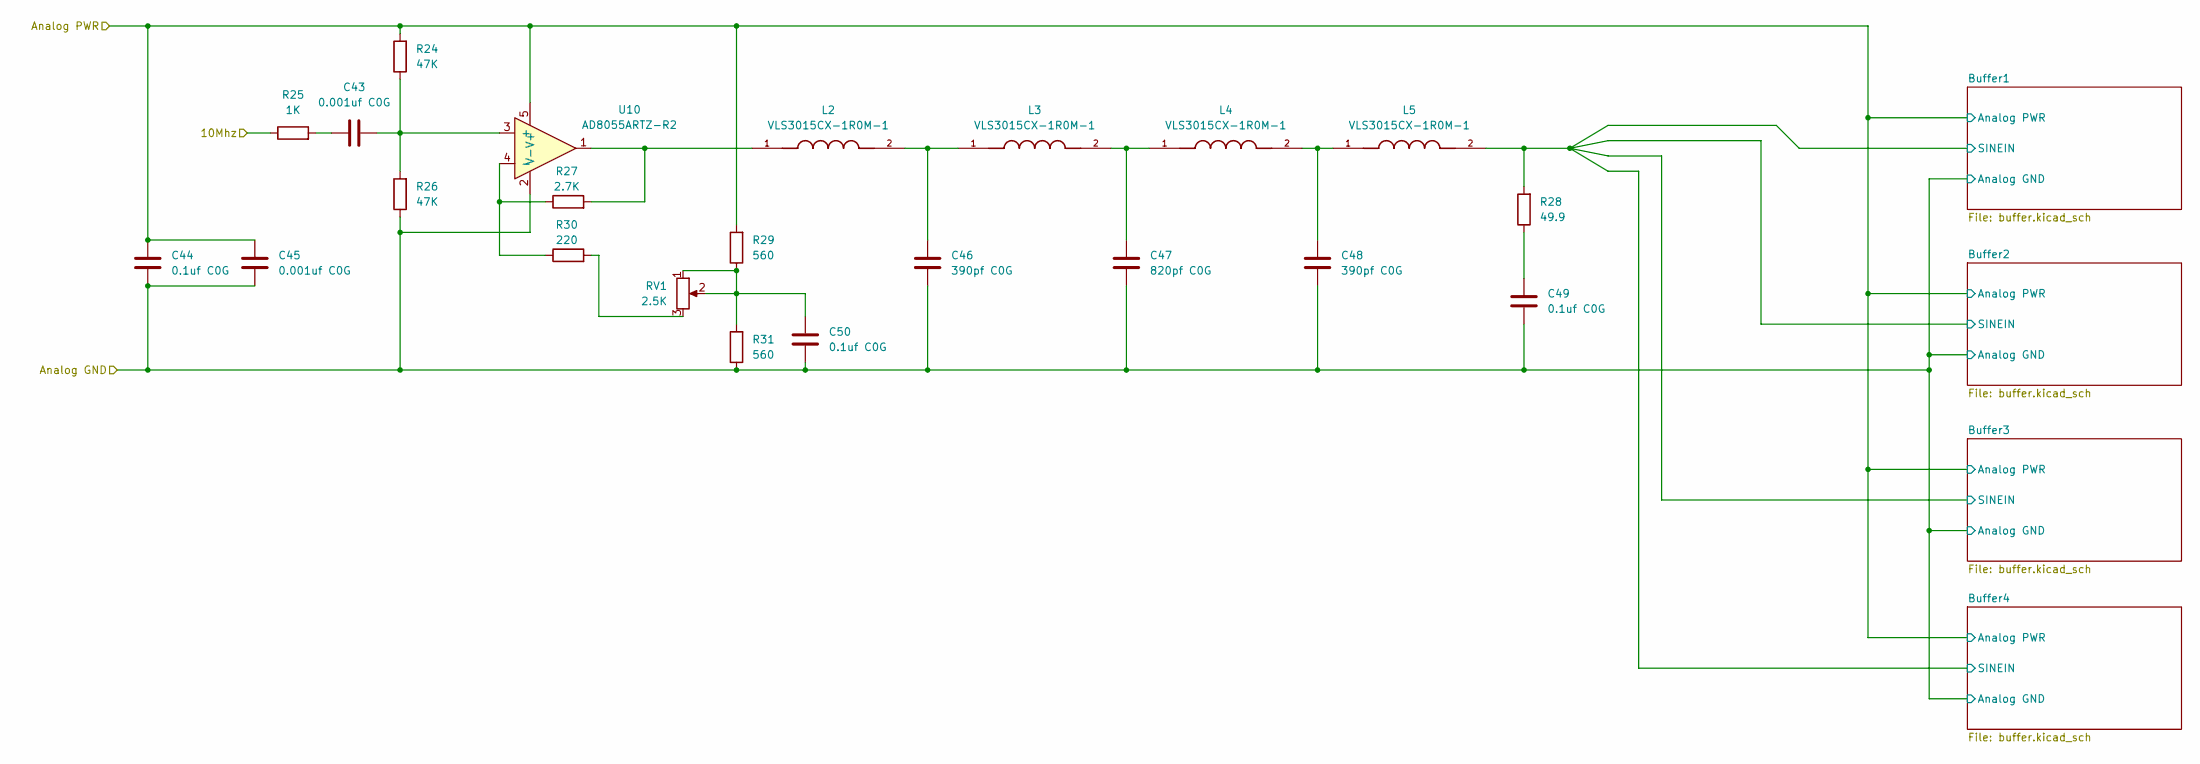
[picture p17: schematic distribution.kicad_sch]

Parts:
C43, C45: 0.001uf C0G; C_1206_3216Metric_Pad1.33x1.80mm_HandSolder
C44, C49, C50: 0.1uf C0G; C_1206_3216Metric_Pad1.33x1.80mm_HandSolder
C46, C48: 390pf C0G; C_1206_3216Metric_Pad1.33x1.80mm_HandSolder
C47: 820pf C0G; C_1206_3216Metric_Pad1.33x1.80mm_HandSolder
L2, L3, L4, L5: VLS3015CX-1R0M-1; IND_VLS3015CX-1R0M-1; PARTREV N/A
R24, R26: 47K; R_1206_3216Metric_Pad1.30x1.75mm_HandSolder
R25: 1K; R_1206_3216Metric_Pad1.30x1.75mm_HandSolder
R27: 2.7K; R_1206_3216Metric_Pad1.30x1.75mm_HandSolder
R28: 49.9; R_1206_3216Metric_Pad1.30x1.75mm_HandSolder
R29, R31: 560; R_1206_3216Metric_Pad1.30x1.75mm_HandSolder
R30: 220; R_1206_3216Metric_Pad1.30x1.75mm_HandSolder
RV1: 2.5K; Potentiometer_Bourns_3296W_Vertical
U10: AD8055ARTZ-R2; SOT95P290X145-5N; MPN AD8055ARTZ-R2

Connections:
/distribution/10Mhz: R25.1; also elsewhere on the board
/distribution/Analog GND: C44.2, C45.2, C46.2, C47.2, C48.2, C49.2, C50.2, R26.1, R31.1, U10.2 (V-); also elsewhere on the board
/distribution/Analog PWR: C44.1, C45.1, R24.2, R29.2, U10.5 (V+); also elsewhere on the board
/distribution/Buffer1/SINEIN: L5.2, R28.2; also elsewhere on the board
unnamed: C43.1, R25.2
unnamed: C46.1, L2.2, L3.1
unnamed: C47.1, L3.2, L4.1
unnamed: C48.1, L4.2, L5.1
unnamed: C49.1, R28.1
unnamed: C50.1, R29.1, R31.2, RV1.1, RV1.2
unnamed: L2.1, R27.2, U10.1
unnamed: R30.2, RV1.3
unnamed: C43.2, R24.1, R26.2, U10.3 (+)
unnamed: R27.1, R30.1, U10.4 (-)

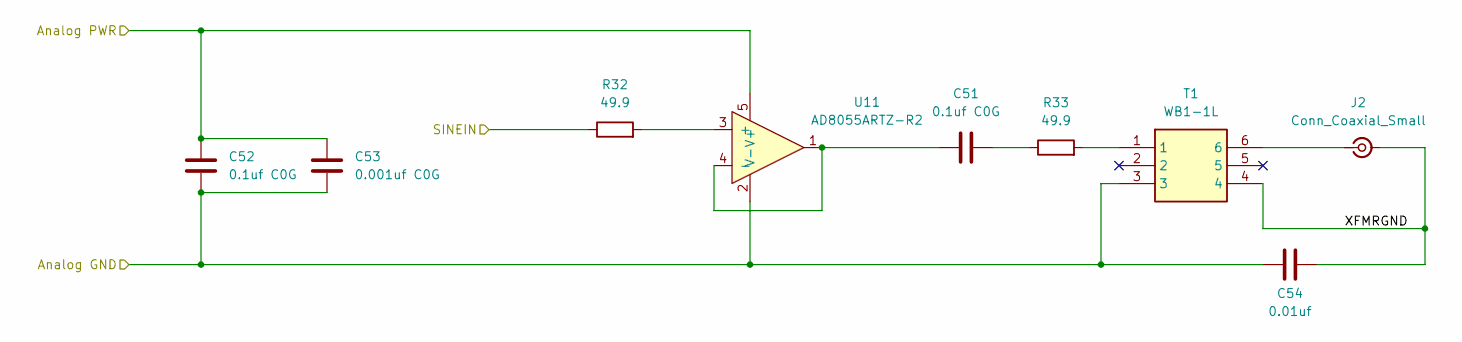
[picture p18: schematic buffer.kicad_sch]

Parts:
C51, C52: 0.1uf C0G; C_1206_3216Metric_Pad1.33x1.80mm_HandSolder
C53: 0.001uf C0G; C_1206_3216Metric_Pad1.33x1.80mm_HandSolder
C54: 0.01uf; C_1206_3216Metric_Pad1.33x1.80mm_HandSolder
J2: Conn_Coaxial_Small; SMA_Amphenol_132291-12_Vertical
R32, R33: 49.9; R_1206_3216Metric_Pad1.30x1.75mm_HandSolder
T1: WB1-1L; DIP762W64P254L826H572Q6N; Manufacturer_Part_Number WB1-1L; Mouser Part Number 994-WB1-1L
U11: AD8055ARTZ-R2; SOT95P290X145-5N; MPN AD8055ARTZ-R2

Connections:
/distribution/Analog GND: C52.2, C53.2, C54.1, T1.3, U11.2 (V-); also elsewhere on the board
/distribution/Analog PWR: C52.1, C53.1, U11.5 (V+); also elsewhere on the board
/distribution/Buffer1/SINEIN: R32.1; also elsewhere on the board
/distribution/Buffer1/XFMRGND: C54.2, J2.2 (Ext), T1.4
unnamed: C51.2, R33.1
unnamed: J2.1 (In), T1.6
unnamed: R33.2, T1.1
unnamed: R32.2, U11.3 (+)
unnamed: C51.1, U11.1, U11.4 (-)

Parts of its further copies:
C55, C56, C59, C60, C63, C64: 0.1uf C0G; C_1206_3216Metric_Pad1.33x1.80mm_HandSolder
C57, C61, C65: 0.001uf C0G; C_1206_3216Metric_Pad1.33x1.80mm_HandSolder
C58, C62, C66: 0.01uf; C_1206_3216Metric_Pad1.33x1.80mm_HandSolder
J3, J4, J5: Conn_Coaxial_Small; SMA_Amphenol_132291-12_Vertical
R34, R35, R36, R37, R38, R39: 49.9; R_1206_3216Metric_Pad1.30x1.75mm_HandSolder
T2, T3, T4: WB1-1L; DIP762W64P254L826H572Q6N; Manufacturer_Part_Number WB1-1L; Mouser Part Number 994-WB1-1L
U12, U13, U14: AD8055ARTZ-R2; SOT95P290X145-5N; MPN AD8055ARTZ-R2

Connections of its further copies:
/distribution/Analog GND: C56.2, C57.2, C58.1, C60.2, C61.2, C62.1, C64.2, C65.2, C66.1, T2.3, T3.3, T4.3, U12.2 (V-), U13.2 (V-), U14.2 (V-); also elsewhere on the board
/distribution/Analog PWR: C56.1, C57.1, C60.1, C61.1, C64.1, C65.1, U12.5 (V+), U13.5 (V+), U14.5 (V+); also elsewhere on the board
/distribution/Buffer1/SINEIN: R34.1, R36.1, R38.1; also elsewhere on the board
/distribution/Buffer2/XFMRGND: C58.2, J3.2 (Ext), T2.4
/distribution/Buffer3/XFMRGND: C62.2, J4.2 (Ext), T3.4
/distribution/Buffer4/XFMRGND: C66.2, J5.2 (Ext), T4.4
unnamed: C55.2, R35.1
unnamed: C59.2, R37.1
unnamed: C63.2, R39.1
unnamed: J3.1 (In), T2.6
unnamed: J4.1 (In), T3.6
unnamed: J5.1 (In), T4.6
unnamed: R35.2, T2.1
unnamed: R37.2, T3.1
unnamed: R39.2, T4.1
unnamed: R34.2, U12.3 (+)
unnamed: C55.1, U12.1, U12.4 (-)
unnamed: R36.2, U13.3 (+)
unnamed: C59.1, U13.1, U13.4 (-)
unnamed: R38.2, U14.3 (+)
unnamed: C63.1, U14.1, U14.4 (-)

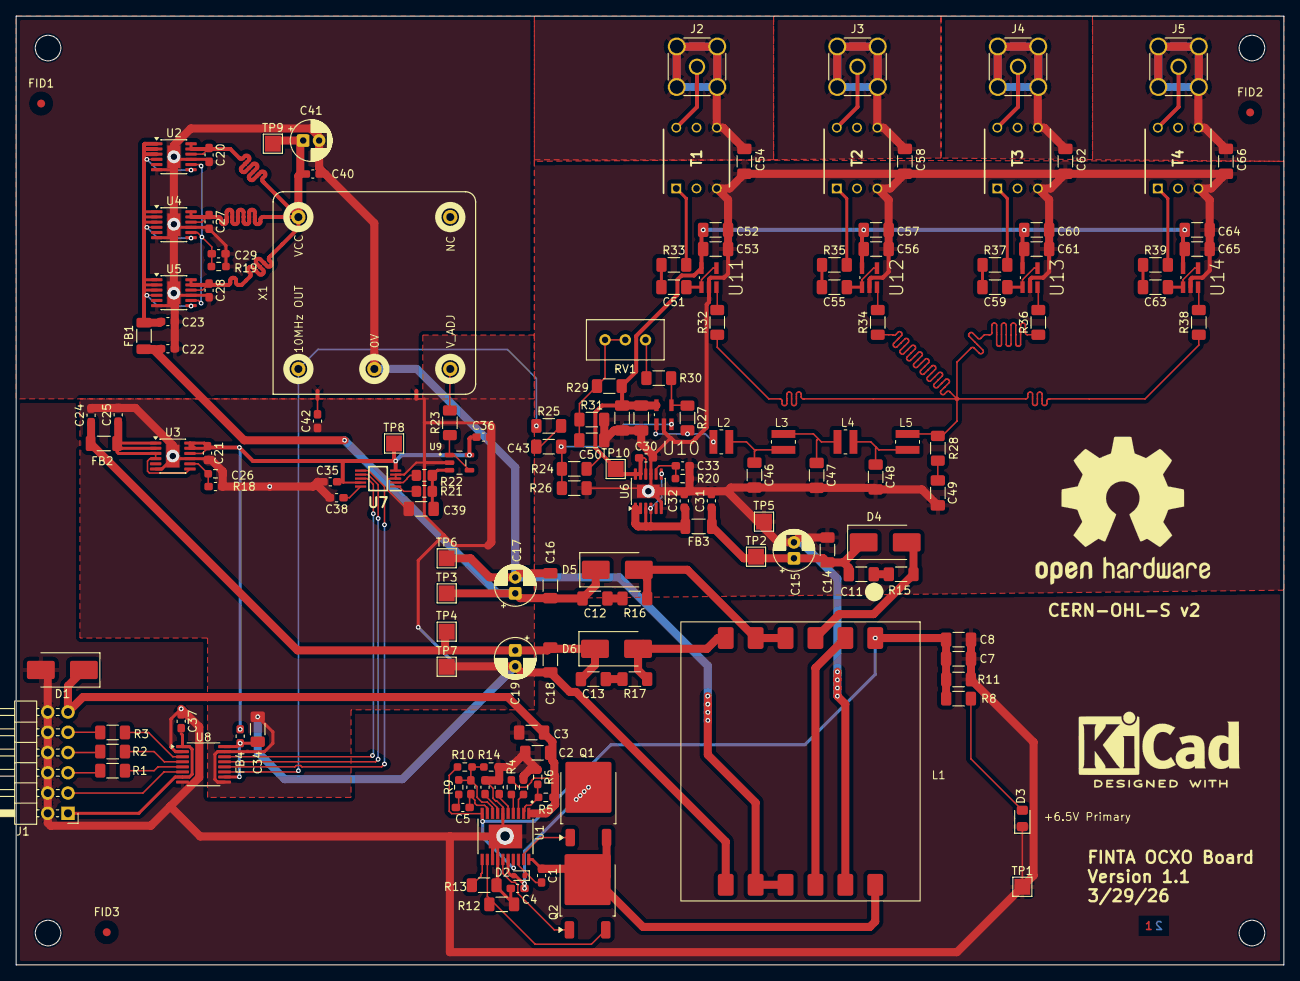
[picture p19: board disciplined-ocxo.kicad_pcb from above]

Board: 2 copper layers, 159.0 x 119.0 mm, 166 parts (0 on the bottom side), 96 nets.
