slburris/Projects-FINTA/KiCAD/gps/gps.kicad_pcb

## KiCad design KiCAD/gps/gps.kicad_pcb (2026-03-26)

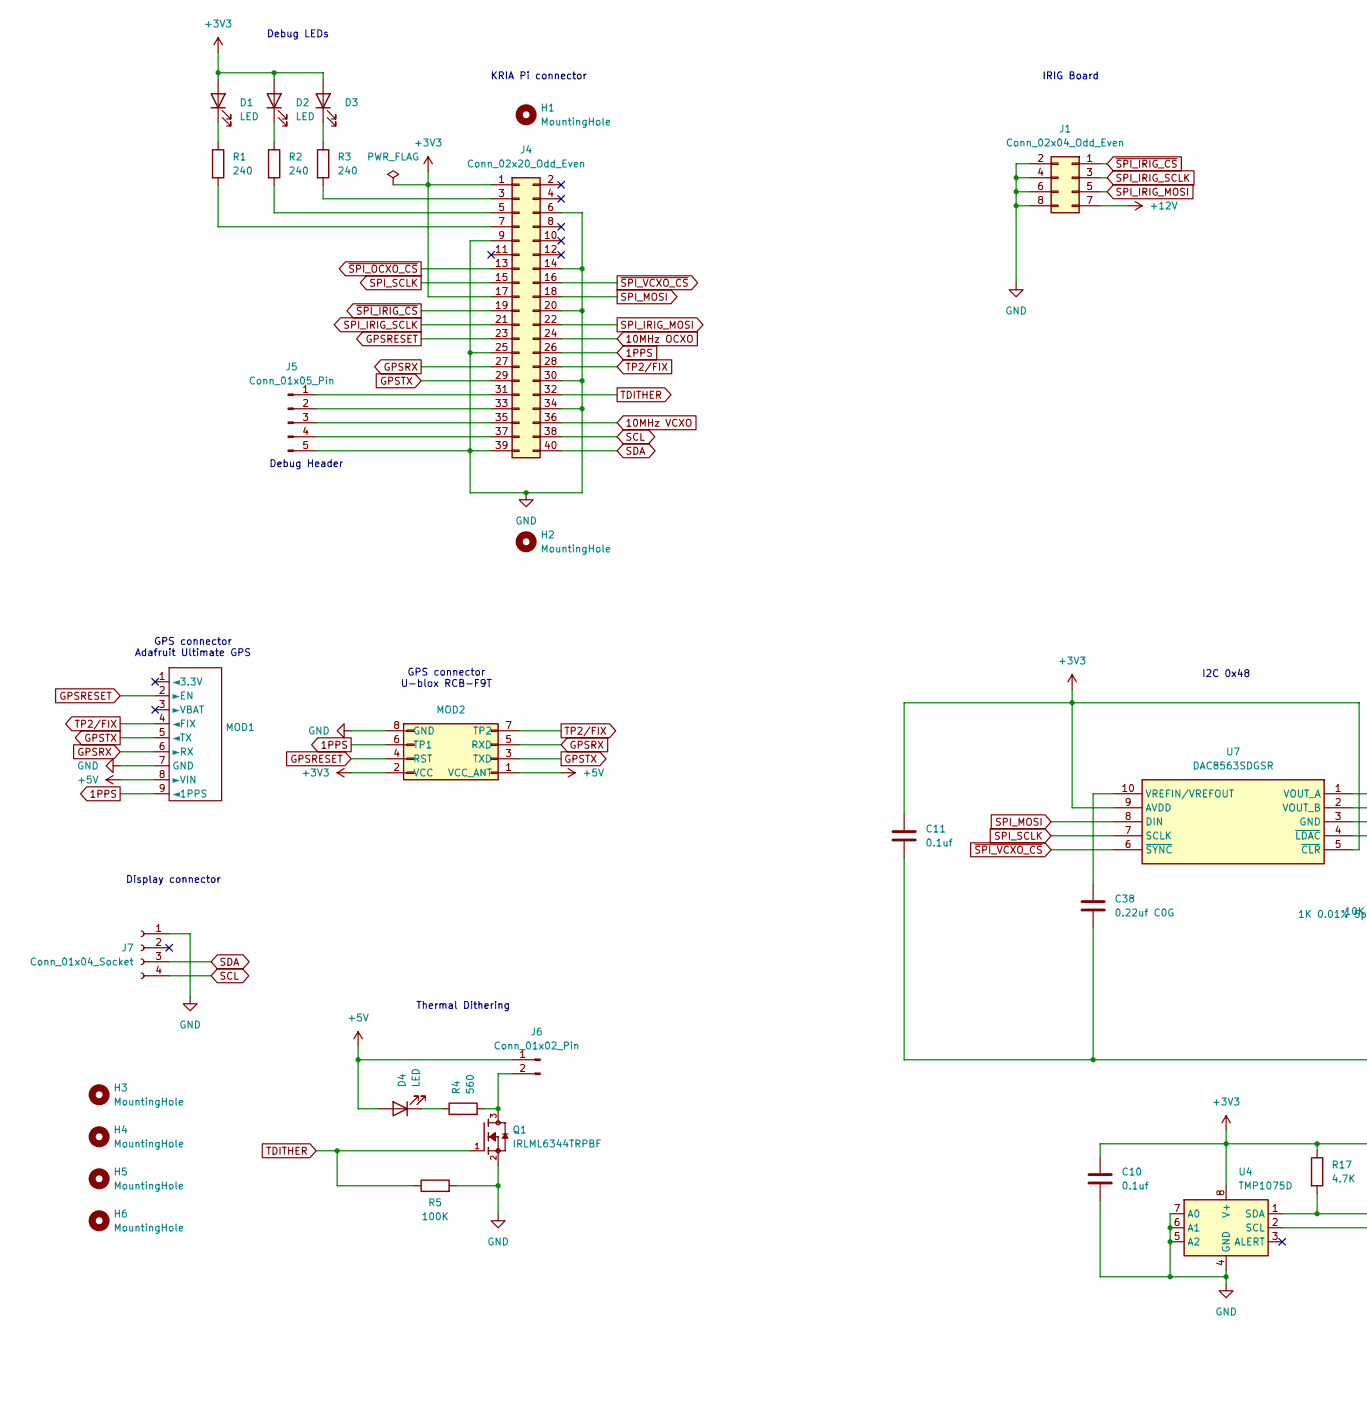
[picture p20: schematic gps.kicad_sch, part in row 1, column 1]

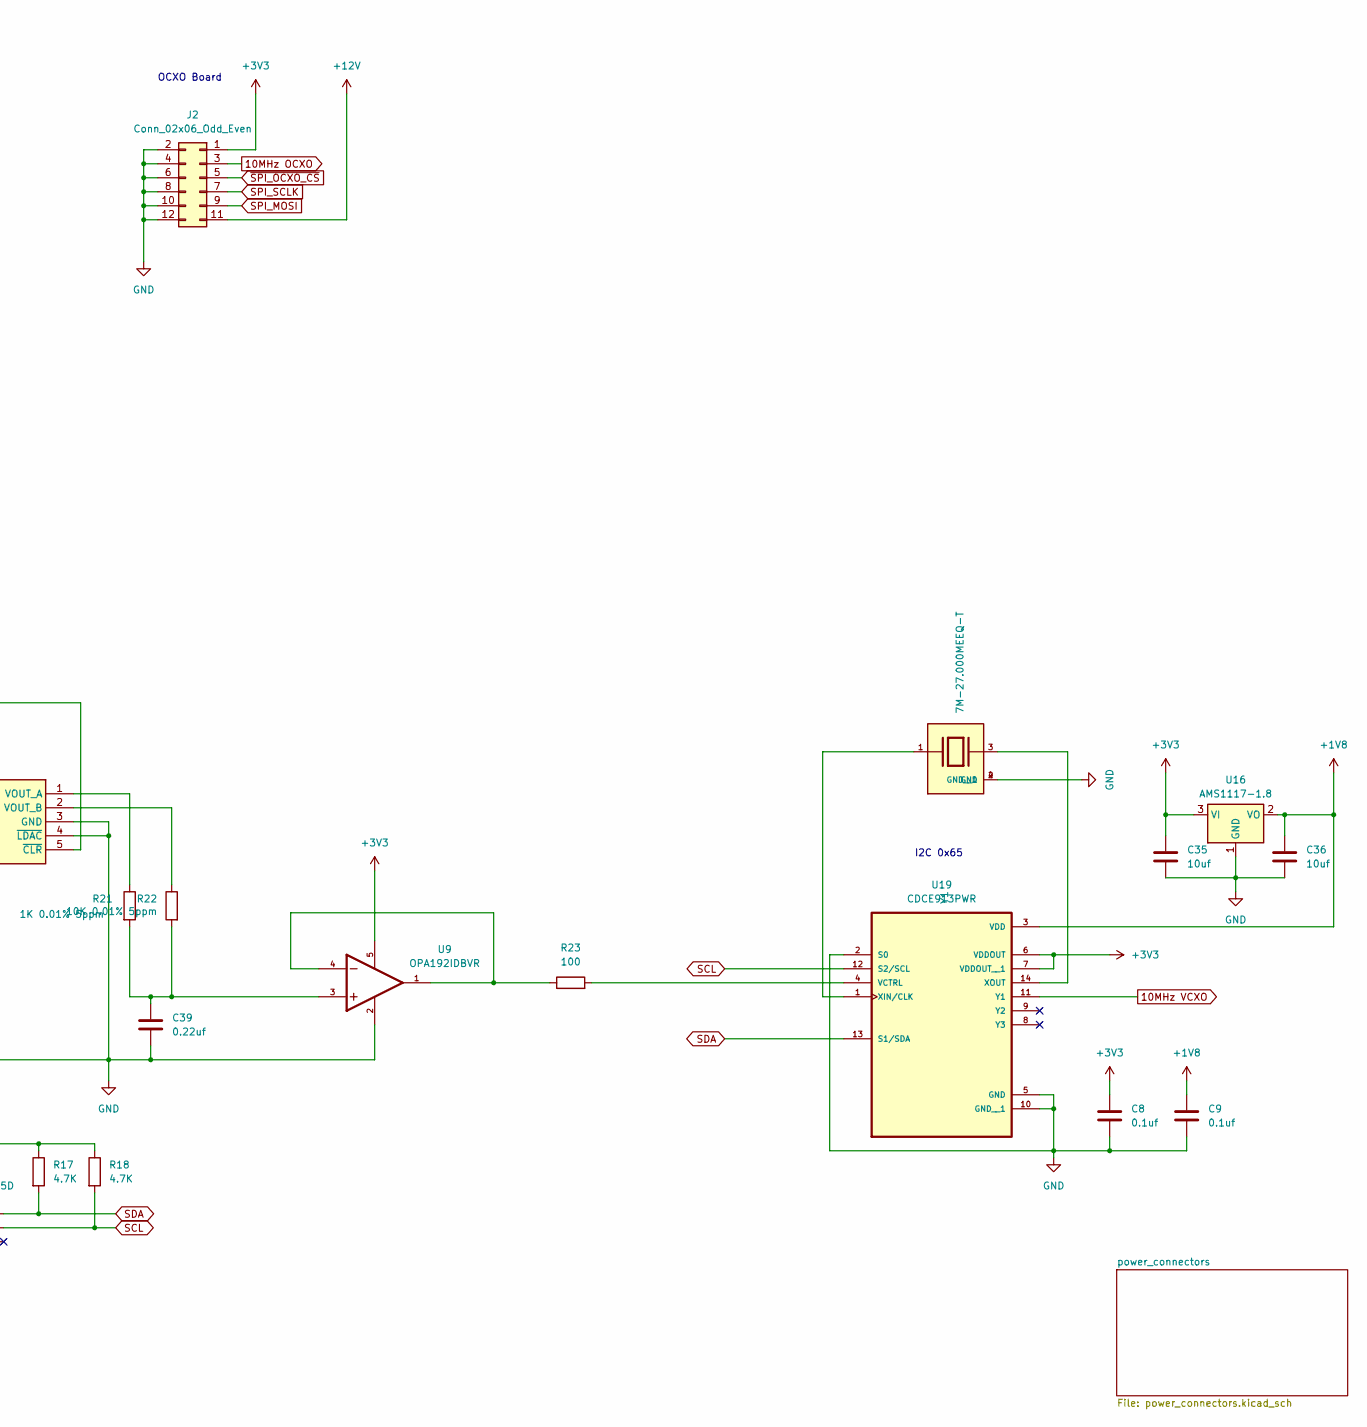
[picture p21: schematic gps.kicad_sch, part in row 1, column 2]

Parts:
C8, C9, C10: 0.1uf; C_0603_1608Metric_Pad1.08x0.95mm_HandSolder
C11: 0.1uf; C_1206_3216Metric_Pad1.33x1.80mm_HandSolder
C35, C36: 10uf; C_1206_3216Metric_Pad1.33x1.80mm_HandSolder
C38: 0.22uf C0G; C_0603_1608Metric_Pad1.08x0.95mm_HandSolder
C39: 0.22uf; C_1206_3216Metric_Pad1.33x1.80mm_HandSolder
D1, D2, D3, D4: LED; LED_0805_2012Metric_Pad1.15x1.40mm_HandSolder
H1, H2: MountingHole; MountingHole_3mm
H3, H4, H5, H6: MountingHole; MountingHole_3.2mm_M3
J1: Conn_02x04_Odd_Even; PinSocket_2x04_P2.54mm_Horizontal
J2: Conn_02x06_Odd_Even; PinSocket_2x06_P2.54mm_Horizontal
J4: Conn_02x20_Odd_Even; PinHeader_2x20_P2.54mm_Vertical
J5: Conn_01x05_Pin; PinHeader_1x05_P2.54mm_Vertical
J6: Conn_01x02_Pin; PinHeader_1x02_P2.54mm_Vertical
J7: Conn_01x04_Socket; JST_PH_B4B-PH-K_1x04_P2.00mm_Vertical
MOD1: Adafruit Ultimate GPS Breakout v3
MOD2: Conn_02x04_Odd_Even; RCB-F9T-0
Q1: IRLML6344TRPBF; TRANS_IRLML6344TRPBF; PARTREV December 19, 2014; DigiKey_Part_Number IRLML6344TRPBFCT-ND
R1, R2, R3: 240; R_1206_3216Metric_Pad1.30x1.75mm_HandSolder
R4: 560; R_1206_3216Metric_Pad1.30x1.75mm_HandSolder
R5: 100K; R_1206_3216Metric_Pad1.30x1.75mm_HandSolder
R17, R18: 4.7K; R_1206_3216Metric_Pad1.30x1.75mm_HandSolder
R21: 1K 0.01% 5ppm; R_0805_2012Metric_Pad1.20x1.40mm_HandSolder
R22: 10K 0.01% 5ppm; R_0805_2012Metric_Pad1.20x1.40mm_HandSolder
R23: 100; R_1206_3216Metric_Pad1.30x1.75mm_HandSolder
U4: TMP1075D; SO-8_3.9x4.9mm_P1.27mm
U7: DAC8563SDGSR; SOP50P490X110-10N; Manufacturer_Part_Number DAC8563SDGSR; Mouser Part Number 595-DAC8563SDGSR
U9: OPA192IDBVR; SOT95P280X145-5N; PARTREV F
U16: AMS1117-1.8; SOT-223-3_TabPin2
U19: CDCE913PWR; SOP65P640X120-14N
Y1: 7M-27.000MEEQ-T; XTAL_7M-27.000MEEQ-T; PARTREV N/A

Connections:
1PPS: J4.26, MOD1.9 (◄1PPS), MOD2.6 (TP1)
10MHz OCXO: J2.3, J4.24
10MHz VCXO: J4.36, U19.11 (Y1)
+1V8: C9.1, C36.1, U16.2 (VO), U19.3 (VDD)
+3V3: C8.1, C10.1, C11.1, C35.1, D1.2 (A), D2.2 (A), D3.2 (A), J2.1, J4.1, J4.17, MOD2.2 (VCC), R17.1, R18.1, U4.8 (V+), U7.5 (~CLR), U7.9 (AVDD), U9.5, U16.3 (VI), U19.6 (VDDOUT), U19.7 (VDDOUT__1)
+5V: D4.2 (A), J6.1, MOD1.8 (►VIN), MOD2.1 (VCC_ANT); also elsewhere on the board
+12V: J1.7, J2.11; also elsewhere on the board
GND: C8.2, C9.2, C10.2, C11.2, C35.2, C36.2, C38.2, C39.2, J1.2, J1.4, J1.6, J1.8, J2.2, J2.4, J2.6, J2.8, J2.10, J2.12, J4.6, J4.9, J4.14, J4.20, J4.25, J4.30, J4.34, J4.39, J5.5, J7.1, MOD1.7 (GND), MOD2.8 (GND), Q1.2, R5.2, U4.4 (GND), U4.5 (A2), U4.6 (A1), U4.7 (A0), U7.3 (GND), U7.4 (~LDAC), U9.2, U16.1 (GND), U19.2 (S0), U19.5 (GND), U19.10 (GND__1), Y1.2 (GND), Y1.4 (GND__1); also elsewhere on the board
GPSRESET: J4.23, MOD1.2 (►EN), MOD2.4 (RST)
GPSRX: J4.27, MOD1.6 (►RX), MOD2.5 (RXD)
GPSTX: J4.29, MOD1.5 (◄TX), MOD2.3 (TXD)
unnamed: C39.1, R21.2, R22.2, U9.3
unnamed: D1.1 (K), R1.1
unnamed: D2.1 (K), R2.1
unnamed: D3.1 (K), R3.1
unnamed: D4.1 (K), R4.1
unnamed: J4.3, R3.2
unnamed: J4.5, R2.2
unnamed: J4.7, R1.2
unnamed: J4.31, J5.1
unnamed: J4.33, J5.2
unnamed: J4.35, J5.3
unnamed: J4.37, J5.4
unnamed: J6.2, Q1.3, R4.2
unnamed: R23.1, U9.1, U9.4
unnamed: R21.1, U7.1 (VOUT_A)
unnamed: R22.1, U7.2 (VOUT_B)
unnamed: C38.1, U7.10 (VREFIN/VREFOUT)
unnamed: R23.2, U19.4 (VCTRL)
unnamed: U19.1 (XIN/CLK), Y1.1
unnamed: U19.14 (XOUT), Y1.3
SCL: J4.38, J7.4, R18.2, U4.2 (SCL), U19.12 (S2/SCL)
SDA: J4.40, J7.3, R17.2, U4.1 (SDA), U19.13 (S1/SDA)
SPI_IRIG_MOSI: J1.5, J4.22
SPI_IRIG_SCLK: J1.3, J4.21
SPI_MOSI: J2.9, J4.18, U7.8 (DIN)
SPI_SCLK: J2.7, J4.15, U7.7 (SCLK)
TDITHER: J4.32, Q1.1, R5.1
TP2/FIX: J4.28, MOD1.4 (◄FIX), MOD2.7 (TP2)
~SPI_IRIG_CS: J1.1, J4.19
~SPI_OCXO_CS: J2.5, J4.13
~SPI_VCXO_CS: J4.16, U7.6 (~SYNC)

Notes on the sheet:
I2C 0x65
I2C 0x48
IRIG Board
Display connector
GPS connector U-blox RCB-F9T
GPS connector Adafruit Ultimate GPS
Debug Header
OCXO Board
Debug LEDs
KRIA Pi connector
Thermal Dithering

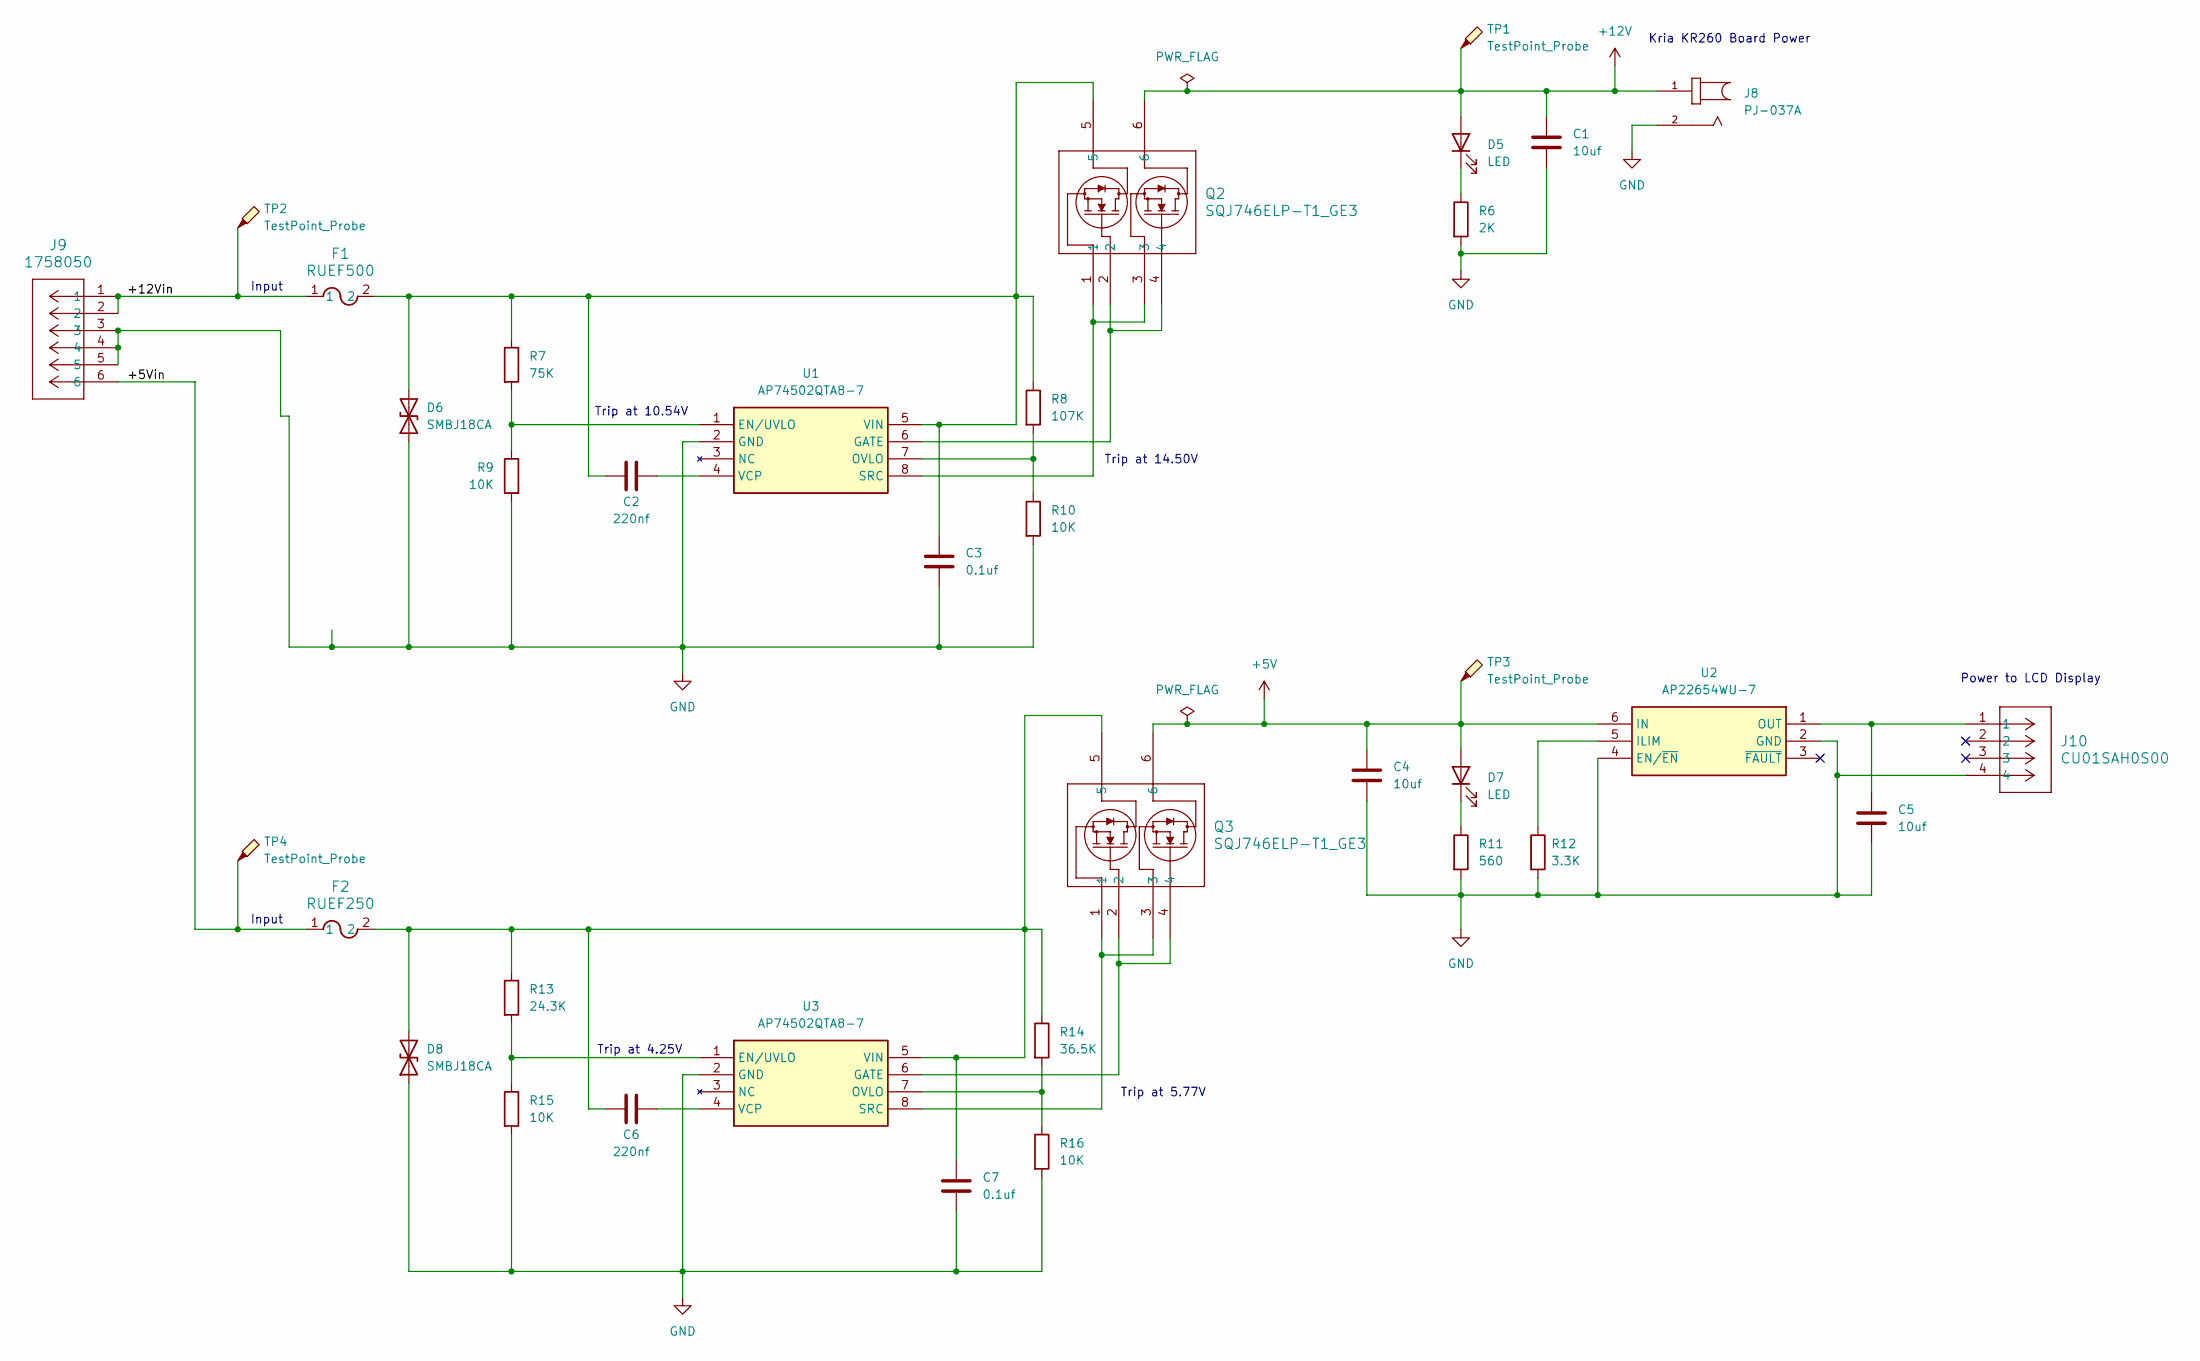
[picture p22: schematic power_connectors.kicad_sch]

Parts:
C1, C4, C5: 10uf; C_1206_3216Metric_Pad1.33x1.80mm_HandSolder
C2, C6: 220nf; C_1206_3216Metric_Pad1.33x1.80mm_HandSolder
C3, C7: 0.1uf; C_1206_3216Metric_Pad1.33x1.80mm_HandSolder
D5, D7: LED; LED_0805_2012Metric_Pad1.15x1.40mm_HandSolder
D6, D8: SMBJ18CA; D_SMB_Handsoldering
F1: RUEF500; FUSE_RUEF500_LTF
F2: RUEF250; FUS_RUEF250_TYCO_TYC
J8: PJ-037A; CUI_PJ-037A
J9: 1758050; CONN_1758050
J10: CU01SAH0S00; CONN_CU01SAH0S00_CVI
Q2, Q3: SQJ746ELP-T1_GE3; PowerPAK_SO-8L-2_DUAL_VIS
R6: 2K; R_1206_3216Metric_Pad1.30x1.75mm_HandSolder
R7: 75K; R_1206_3216Metric_Pad1.30x1.75mm_HandSolder
R8: 107K; R_1206_3216Metric_Pad1.30x1.75mm_HandSolder
R9, R10, R15, R16: 10K; R_1206_3216Metric_Pad1.30x1.75mm_HandSolder
R11: 560; R_1206_3216Metric_Pad1.30x1.75mm_HandSolder
R12: 3.3K; R_1206_3216Metric_Pad1.30x1.75mm_HandSolder
R13: 24.3K; R_1206_3216Metric_Pad1.30x1.75mm_HandSolder
R14: 36.5K; R_1206_3216Metric_Pad1.30x1.75mm_HandSolder
TP1, TP2, TP3, TP4: TestPoint_Probe; TestPoint_Pad_2.0x2.0mm
U1, U3: AP74502QTA8-7; SOT65P280X110-8N; Manufacturer_Part_Number AP74502QTA8-7
U2: AP22654WU-7; SOT95P280X82-6N; Mouser Part Number 621-AP22654QWU-7

Connections:
+5V: C4.1, D7.2 (A), Q3.6, TP3.1, U2.6 (IN); also elsewhere on the board
+12V: C1.1, D5.2 (A), J8.1, Q2.6, TP1.1; also elsewhere on the board
/power_connectors/+5Vin: F2.1, J9.6, TP4.1
/power_connectors/+12Vin: F1.1, J9.1, J9.2, TP2.1
GND: C1.2, C3.2, C4.2, C5.2, C7.2, D6.1 (A1), D8.1 (A1), J8.2, J9.3, J9.4, J9.5, J10.4, R6.2, R9.2, R10.2, R11.2, R12.2, R15.2, R16.2, U1.2 (GND), U2.2 (GND), U2.4 (EN/~EN), U3.2 (GND); also elsewhere on the board
unnamed: D5.1 (K), R6.1
unnamed: C2.1, C3.1, D6.2 (A2), F1.2, Q2.5, R7.1, R8.1, U1.5 (VIN)
unnamed: D7.1 (K), R11.1
unnamed: C6.1, C7.1, D8.2 (A2), F2.2, Q3.5, R13.1, R14.1, U3.5 (VIN)
unnamed: R7.2, R9.1, U1.1 (EN/UVLO)
unnamed: Q2.2, Q2.4, U1.6 (GATE)
unnamed: R8.2, R10.1, U1.7 (OVLO)
unnamed: Q2.1, Q2.3, U1.8 (SRC)
unnamed: C2.2, U1.4 (VCP)
unnamed: R12.1, U2.5 (ILIM)
unnamed: C5.1, J10.1, U2.1 (OUT)
unnamed: R13.2, R15.1, U3.1 (EN/UVLO)
unnamed: Q3.2, Q3.4, U3.6 (GATE)
unnamed: R14.2, R16.1, U3.7 (OVLO)
unnamed: Q3.1, Q3.3, U3.8 (SRC)
unnamed: C6.2, U3.4 (VCP)

Notes on the sheet:
Trip at 5.77V
Power to LCD Display
Trip at 10.54V
Trip at 4.25V
Input
Kria KR260 Board Power
Trip at 14.50V

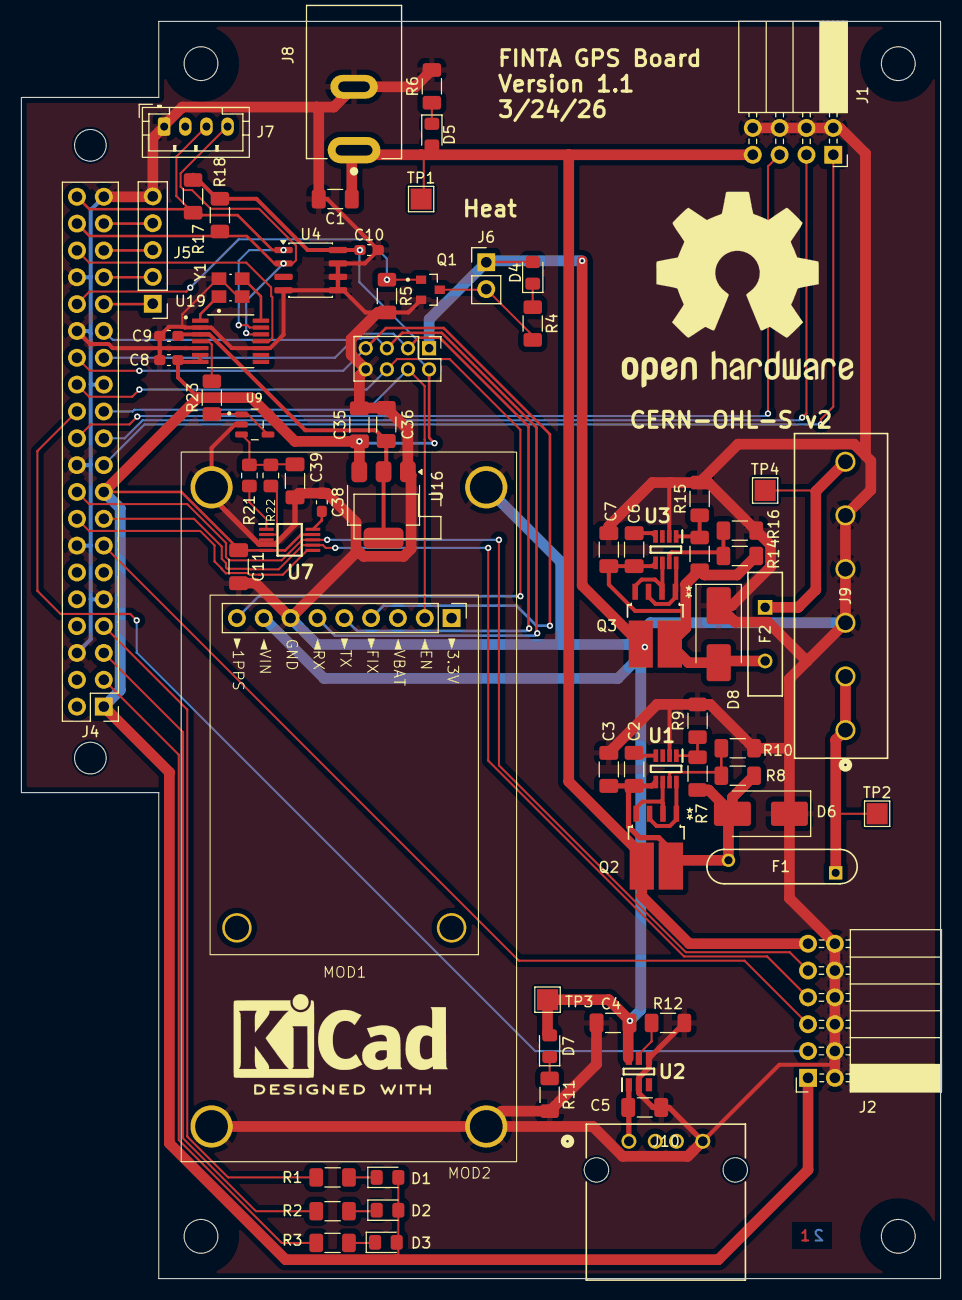
[picture p23: board gps.kicad_pcb from above]

Board: 2 copper layers, 87.0 x 119.0 mm, 79 parts (0 on the bottom side), 60 nets.
