slburris/Projects-FINTA/KiCAD/IRIG/IRIG.kicad_pcb

## KiCad design KiCAD/IRIG/IRIG.kicad_pcb (2026-02-25)

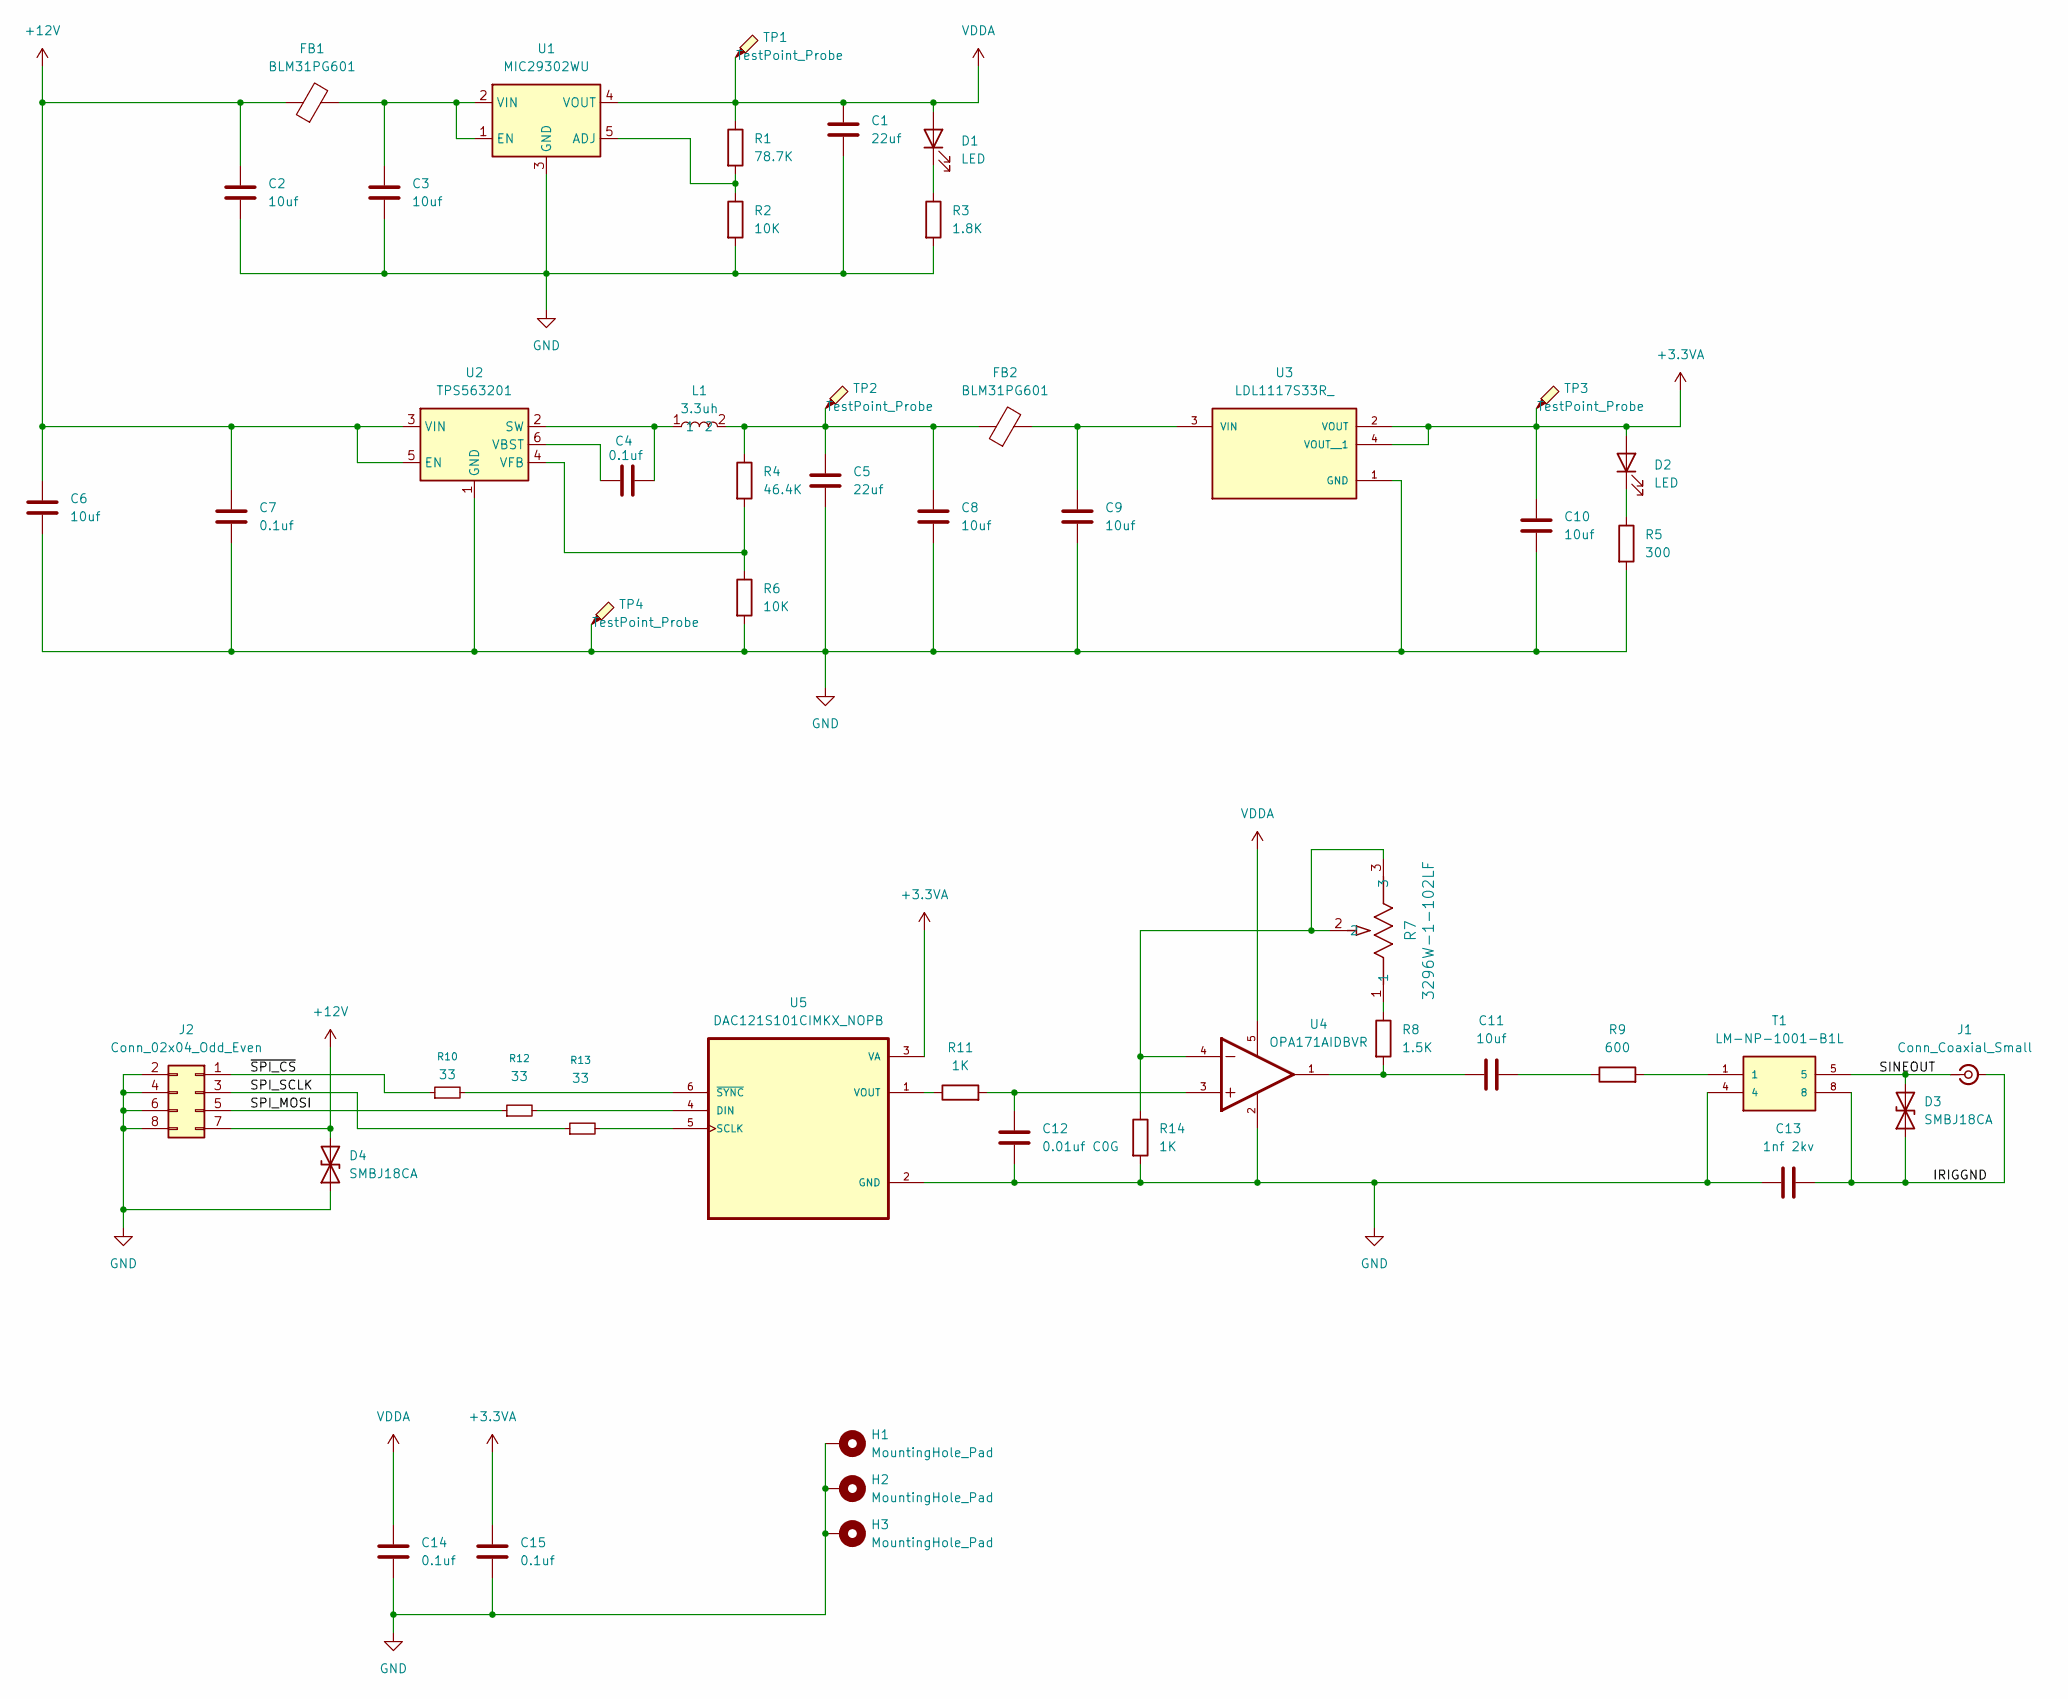
[picture p24: schematic IRIG.kicad_sch]

Parts:
C1, C5: 22uf; C_1206_3216Metric_Pad1.33x1.80mm_HandSolder
C2, C3, C6, C8, C9, C10, C11: 10uf; C_1206_3216Metric_Pad1.33x1.80mm_HandSolder
C4, C7, C14, C15: 0.1uf; C_1206_3216Metric_Pad1.33x1.80mm_HandSolder
C12: 0.01uf C0G; C_1206_3216Metric_Pad1.33x1.80mm_HandSolder
C13: 1nf 2kv; C_1206_3216Metric_Pad1.33x1.80mm_HandSolder
D1, D2: LED; LED_0805_2012Metric_Pad1.15x1.40mm_HandSolder
D3, D4: SMBJ18CA; D_SMB_Handsoldering
FB1, FB2: BLM31PG601; L_1206_3216Metric_Pad1.22x1.90mm_HandSolder
H1, H2, H3: MountingHole_Pad; MountingHole_3.2mm_M3_Pad
J1: Conn_Coaxial_Small; SMA_Amphenol_132291-12_Vertical
J2: Conn_02x04_Odd_Even; PinHeader_2x04_P2.54mm_Horizontal
L1: 3.3uh; BCIHP10SC
R1: 78.7K; R_1206_3216Metric_Pad1.30x1.75mm_HandSolder
R2, R6: 10K; R_1206_3216Metric_Pad1.30x1.75mm_HandSolder
R3: 1.8K; R_1206_3216Metric_Pad1.30x1.75mm_HandSolder
R4: 46.4K; R_1206_3216Metric_Pad1.30x1.75mm_HandSolder
R5: 300; R_1206_3216Metric_Pad1.30x1.75mm_HandSolder
R7: 3296W-1-102LF; POT_3296W
R8: 1.5K; R_1206_3216Metric_Pad1.30x1.75mm_HandSolder
R9: 600; R_1206_3216Metric_Pad1.30x1.75mm_HandSolder
R10, R12, R13: 33; R_1206_3216Metric_Pad1.30x1.75mm_HandSolder
R11, R14: 1K; R_1206_3216Metric_Pad1.30x1.75mm_HandSolder
T1: LM-NP-1001-B1L; LMNP1001B1L; MOUSER_PART_NUMBER 652-LM-NP-1001-B1L; DigiKey_Part_Number LM-NP-1001-B1L-ND
TP1, TP2, TP3, TP4: TestPoint_Probe; TestPoint_Pad_2.0x2.0mm
U1: MIC29302WU; TO-263-5_TabPin3
U2: TPS563201; SOT-23-6
U3: LDL1117S33R_; SOT230P700X180-4N; PARTREV 7
U4: OPA171AIDBVR; SOT95P280X145-5NOPA171
U5: DAC121S101CIMKX_NOPB; SOT95P280X110-6N

Connections:
+3.3VA: C10.1, C15.1, D2.2 (A), TP3.1, U3.2 (VOUT), U3.4 (VOUT__1), U5.3 (VA)
+12V: C2.1, C6.1, C7.1, D4.2 (A2), FB1.1, J2.7, U2.3 (VIN), U2.5 (EN)
/IRIGGND: C13.2, D3.1 (A1), J1.2 (Ext), T1.8
/SINEOUT: D3.2 (A2), J1.1 (In), T1.5
/SPI_MOSI: J2.5, R12.1
/SPI_SCLK: J2.3, R13.1
/~SPI_CS: J2.1, R10.1
GND: C1.2, C2.2, C3.2, C5.2, C6.2, C7.2, C8.2, C9.2, C10.2, C12.2, C13.1, C14.2, C15.2, D4.1 (A1), H1.1, H2.1, H3.1, J2.2, J2.4, J2.6, J2.8, R2.2, R3.2, R5.2, R6.2, R14.2, T1.4, TP4.1, U1.3 (GND), U2.1 (GND), U3.1 (GND), U4.2, U5.2 (GND)
unnamed: C5.1, C8.1, FB2.1, L1.2, R4.1, TP2.1
unnamed: C11.1, R8.2, U4.1
unnamed: C11.2, R9.1
unnamed: C12.1, R11.2, U4.3
unnamed: D1.1 (K), R3.1
unnamed: D2.1 (K), R5.1
unnamed: R7.1, R8.1
unnamed: R9.2, T1.1
unnamed: R7.2, R7.3, R14.1, U4.4
unnamed: R1.2, R2.1, U1.5 (ADJ)
unnamed: C3.1, FB1.2, U1.1 (EN), U1.2 (VIN)
unnamed: C4.2, L1.1, U2.2 (SW)
unnamed: C4.1, U2.6 (VBST)
unnamed: R4.2, R6.1, U2.4 (VFB)
unnamed: C9.1, FB2.2, U3.3 (VIN)
unnamed: R12.2, U5.4 (DIN)
unnamed: R13.2, U5.5 (SCLK)
unnamed: R11.1, U5.1 (VOUT)
unnamed: R10.2, U5.6 (~SYNC)
VDDA: C1.1, C14.1, D1.2 (A), R1.1, TP1.1, U1.4 (VOUT), U4.5

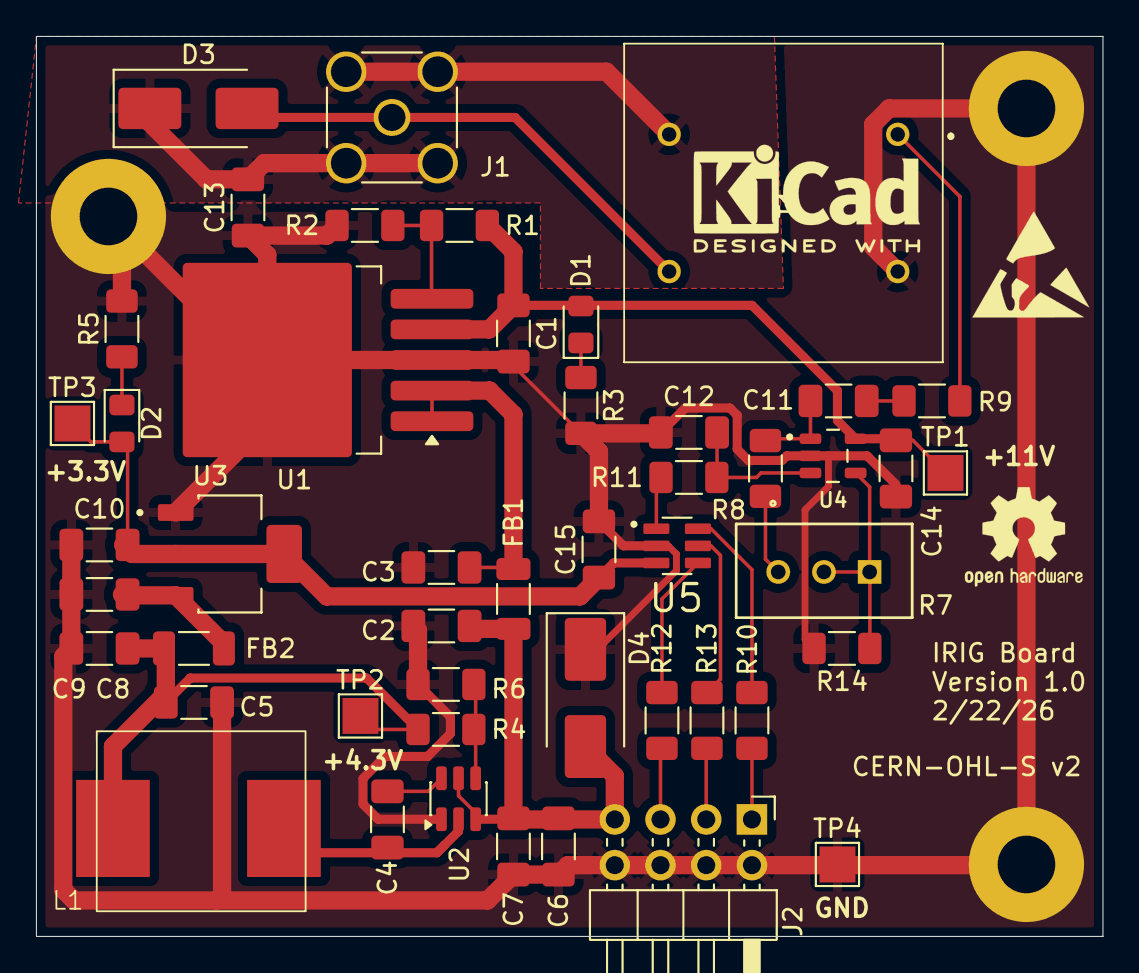
[picture p25: board IRIG.kicad_pcb from above]

Board: 2 copper layers, 59.2 x 50.0 mm, 51 parts (0 on the bottom side), 28 nets.
