slburris/Projects-FINTA/(commit log)

2026-02-05 more init
    [IRIG-B.kicad_pcb, IRIG-B.kicad_sch, bom.csv, buffer.kicad_sch, designators.csv, distribution.kicad_sch, ocxo.kicad_pcb, ocxo.kicad_sch]
2026-02-15 before switchover to new daughtercard format
    [IRIG-B.kicad_pcb, IRIG-B.kicad_sch, IRIG.kicad_sch, aux.kicad_pcb, aux.kicad_sch, bom.csv, buffer.kicad_sch, designators.csv]
2026-02-22 Reworked, now with IRIG option board complete
    [IRIG.kicad_pcb, IRIG.kicad_sch, aux.kicad_pcb, aux.kicad_sch, bom.csv, buffer.kicad_sch, connectors.kicad_sch, designators.csv]
2026-02-25 Rework to real version 1.0, with separate GPS, OCXO, and IRIG boards
    [IRIG.kicad_pcb, IRIG.kicad_sch, aux.kicad_pcb, aux.kicad_sch, buffer.kicad_sch, connectors.kicad_sch, disciplined-ocxo.kicad_pcb, disciplined-ocxo.kicad_sch]
2026-02-27 Added FPGA debug header and debug LEDs
    [bom.csv, designators.csv, disciplined-ocxo.kicad_pcb, gps.kicad_pcb, gps.kicad_sch, positions.csv, power_connectors.kicad_sch]
2026-03-26 gps PCB 1.1
    [bom.csv, designators.csv, disciplined-ocxo.kicad_pcb, gps.kicad_pcb, gps.kicad_sch, positions.csv, power_connectors.kicad_sch, pre-reg power.kicad_sch]
2026-03-30 ocxo board 1.1, with fixes for the major errors
    [disciplined-ocxo.kicad_pcb, disciplined-ocxo.kicad_sch, ocxo.kicad_sch, pre-reg power.kicad_sch]
2026-05-14 OCXO board 1.1
    [bom.csv, designators.csv, disciplined-ocxo.kicad_pcb, ocxo.kicad_sch, positions.csv, pre-reg power.kicad_sch]
2026-05-15 LDO daughterboard 1.1
    [bom.csv, designators.csv, flybuck.kicad_pcb, flybuck.kicad_sch, lownoise-LDO.kicad_pcb, lownoise-LDO.kicad_sch, ocxo-mezzanine.kicad_pcb, ocxo-mezzanine.kicad_sch]
