slburris/Projects-FINTA/(notices)

Notices in the files:
KiCAD/IRIG/IRIG.kicad_pcb:
CERN-OHL-S v2
